EasyAsABC123/Chromance/Models/README.md

# Models

The existing `RegularNode.f3d`, `TopCenterNode.f3d`, `TopLeftNode.f3d` and
`TopRightNode.f3d` files are the Chromance lighting-node designs.

[ESP32 enclosure](ESP32Enclosure/) contains a separate parametric under-desk
controller enclosure, preserved design revisions, STEP solids for Fusion, 3MF
print meshes, geometry previews, hardware notes and a reproducible Python CAD
environment.
