EasyAsABC123/Chromance/Models/ESP32Enclosure/revisions/008-corner-bosses/replacement-parts.png

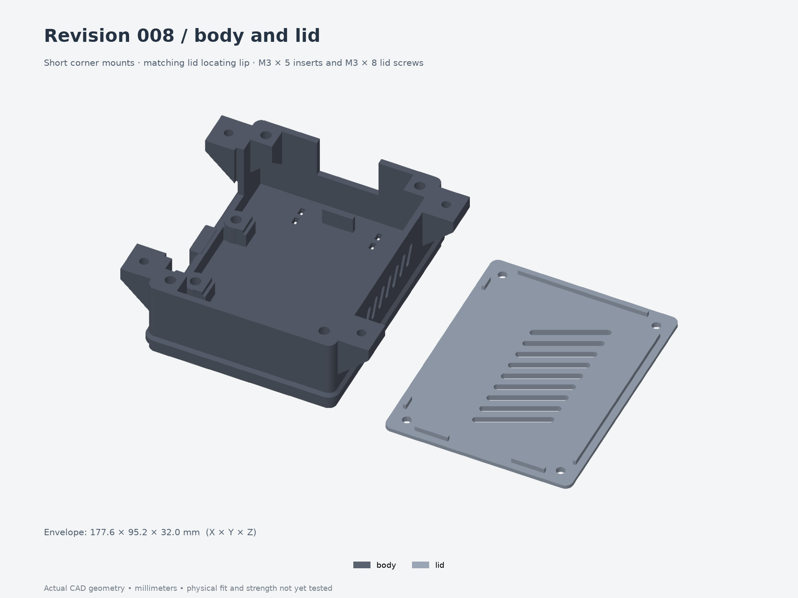
Models/ESP32Enclosure/revisions/008-corner-bosses/replacement-parts.png
