EasyAsABC123/Chromance/Models/ESP32Enclosure/fit-tests/001-board-fit/assembly.step

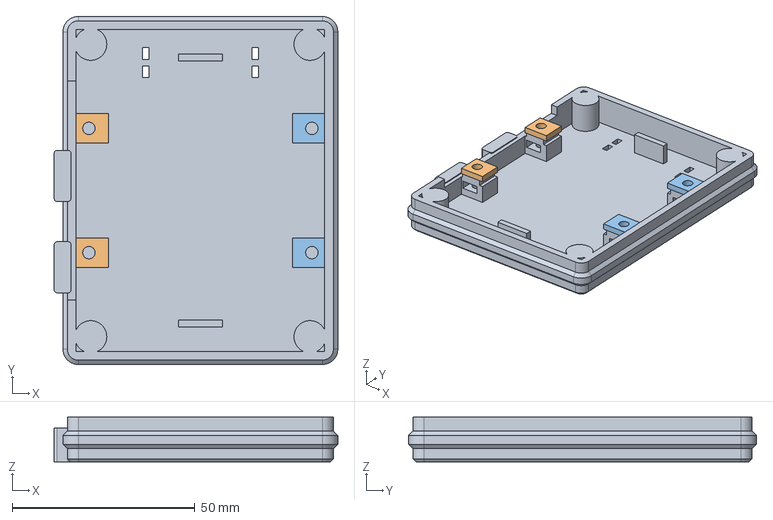
[picture p4: CAD file, 2026-09-10]
Models/ESP32Enclosure/fit-tests/001-board-fit/assembly.step
77.6 x 95.2 x 12.2 mm
