EasyAsABC123/Chromance/Models/ESP32Enclosure/revisions/009-cable-retention/assembly.step

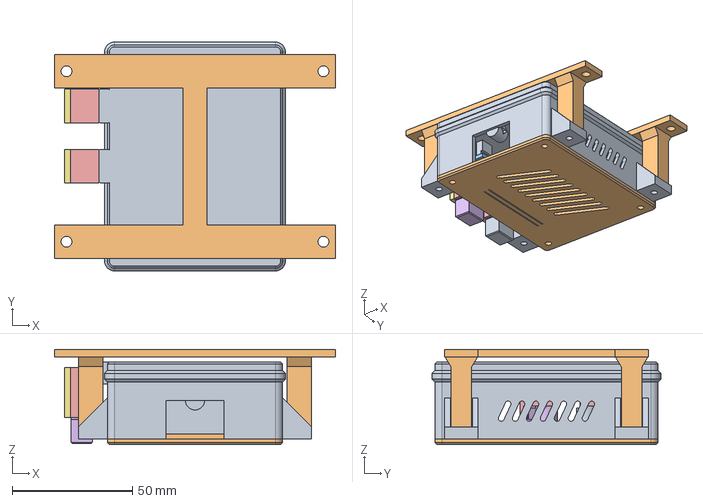
[picture p5: CAD file, 2026-09-11]
Models/ESP32Enclosure/revisions/009-cable-retention/assembly.step
116.8 x 95.2 x 39.6 mm
