EasyAsABC123/Chromance/Models/ESP32Enclosure/revisions/013-measured-buttons/assembly.step

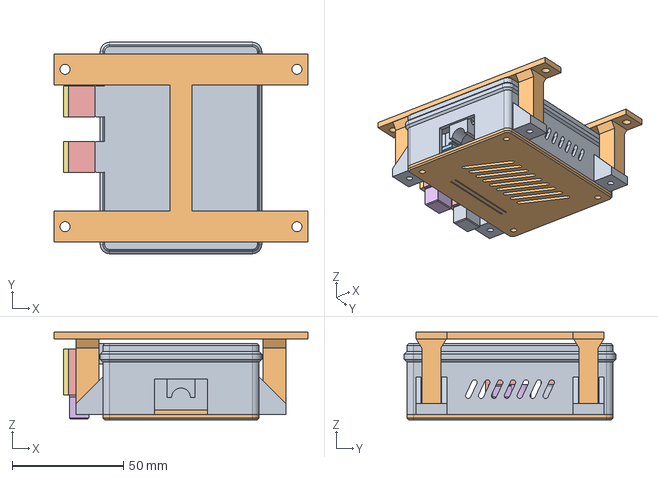
[picture p6: CAD file, 2026-09-13]
Models/ESP32Enclosure/revisions/013-measured-buttons/assembly.step
114.3 x 95.2 x 39.6 mm
