EasyAsABC123/Chromance/Models/ESP32Enclosure/fit-tests/003-cable-retention/assembly.step

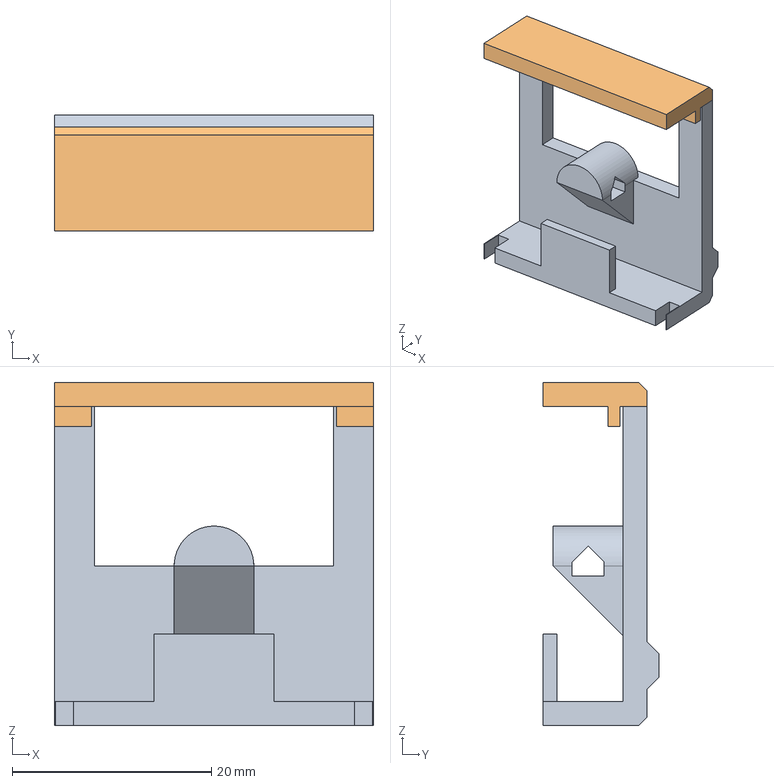
[picture p7: CAD file, 2026-09-11]
Models/ESP32Enclosure/fit-tests/003-cable-retention/assembly.step
32.0 x 11.6 x 34.4 mm
