EasyAsABC123/Chromance/Models/ESP32Enclosure/fit-tests/005-board-width/assembly.step

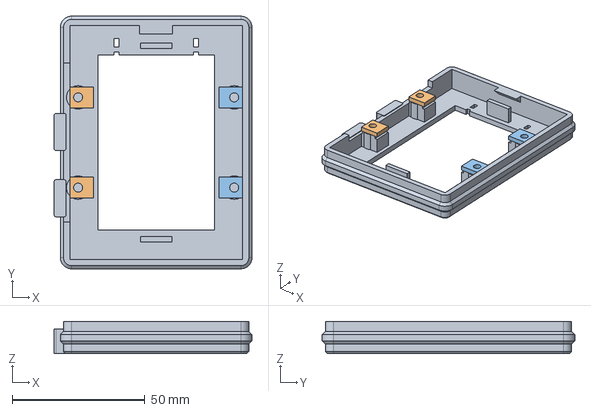
[picture p8: CAD file, 2026-09-11]
Models/ESP32Enclosure/fit-tests/005-board-width/assembly.step
74.6 x 95.2 x 12.2 mm
