EasyAsABC123/Chromance/Models/ESP32Enclosure/fit-tests/008-button-alignment/assembly.step

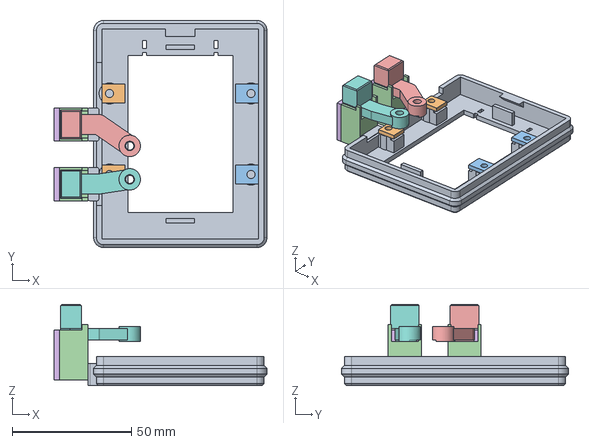
[picture p9: CAD file, 2026-09-13]
Models/ESP32Enclosure/fit-tests/008-button-alignment/assembly.step
89.3 x 95.2 x 34.0 mm
