EasyAsABC123/Chromance/Models/ESP32Enclosure/fit-tests/006-cable-cradle/assembly.step

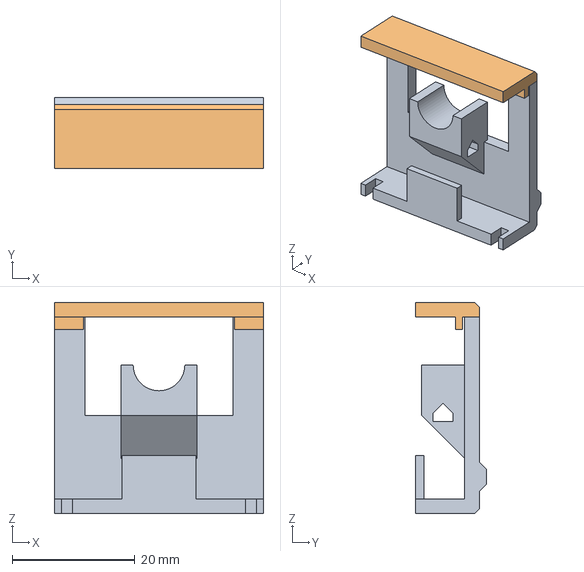
[picture p10: CAD file, 2026-09-11]
Models/ESP32Enclosure/fit-tests/006-cable-cradle/assembly.step
34.0 x 11.6 x 34.4 mm
