EasyAsABC123/Chromance/Models/ESP32Enclosure/revisions/001-generic/assembly.step

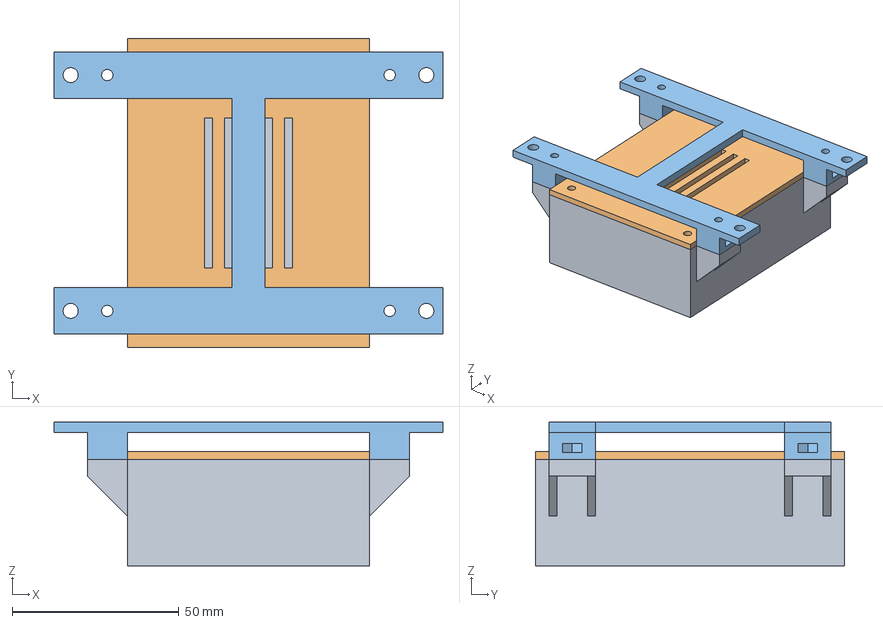
[picture p11: CAD file, 2026-09-09]
Models/ESP32Enclosure/revisions/001-generic/assembly.step
116.8 x 92.8 x 43.2 mm
