EasyAsABC123/Chromance/Models/ESP32Enclosure/revisions/002-console/assembly.step

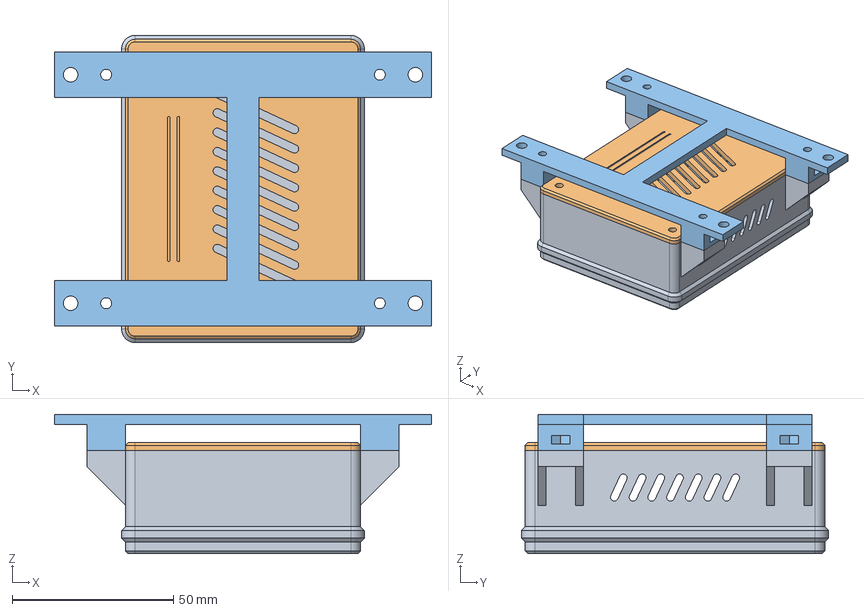
[picture p12: CAD file, 2026-09-09]
Models/ESP32Enclosure/revisions/002-console/assembly.step
116.8 x 95.2 x 43.2 mm
