EasyAsABC123/Chromance/Models/ESP32Enclosure/revisions/003-buttons/assembly.step

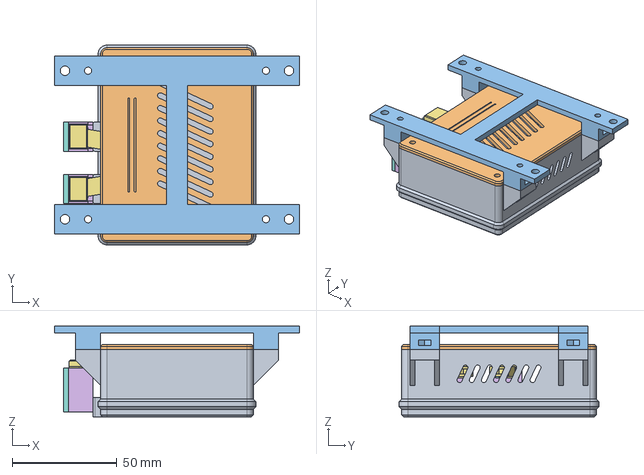
[picture p13: CAD file, 2026-09-09]
Models/ESP32Enclosure/revisions/003-buttons/assembly.step
116.8 x 95.2 x 43.2 mm
