EasyAsABC123/Chromance/Models/ESP32Enclosure/revisions/005-downward-buttons/assembly.step

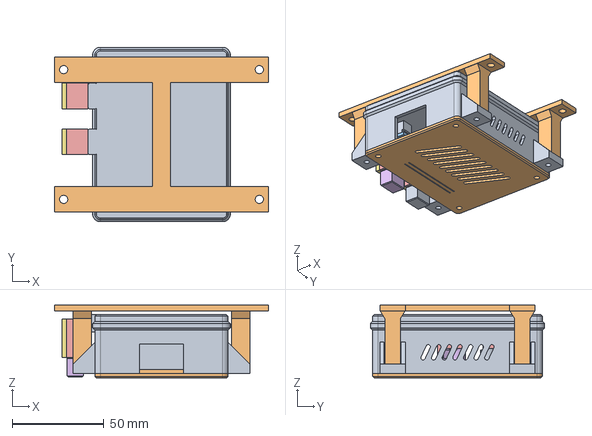
[picture p14: CAD file, 2026-09-10]
Models/ESP32Enclosure/revisions/005-downward-buttons/assembly.step
116.8 x 95.2 x 39.6 mm
