EasyAsABC123/Chromance/Models/ESP32Enclosure/revisions/007-pcb-heatsets/assembly.step

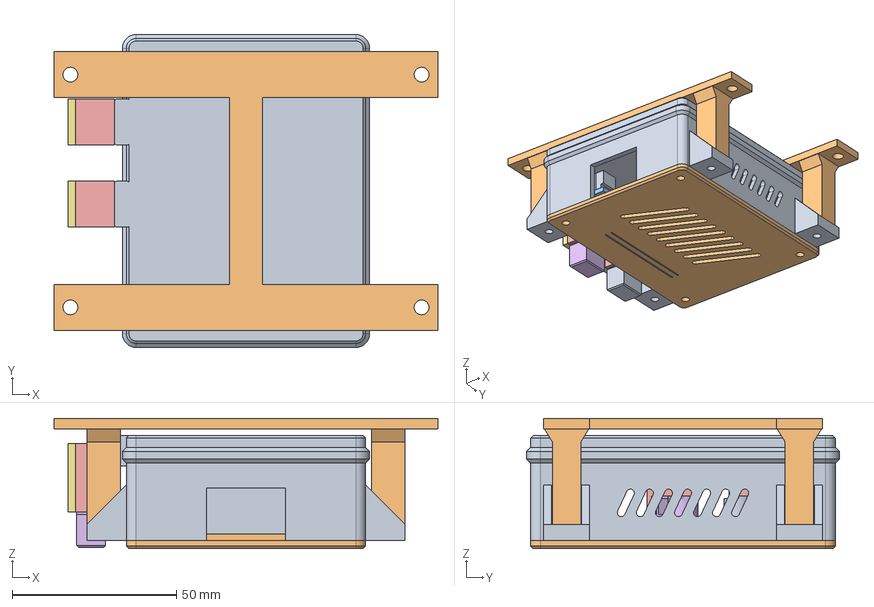
[picture p15: CAD file, 2026-09-11]
Models/ESP32Enclosure/revisions/007-pcb-heatsets/assembly.step
116.8 x 95.2 x 39.6 mm
