EasyAsABC123/Chromance/Models/ESP32Enclosure/fit-tests/002-board-fit-heatsets/parts/board_fit_tray.step

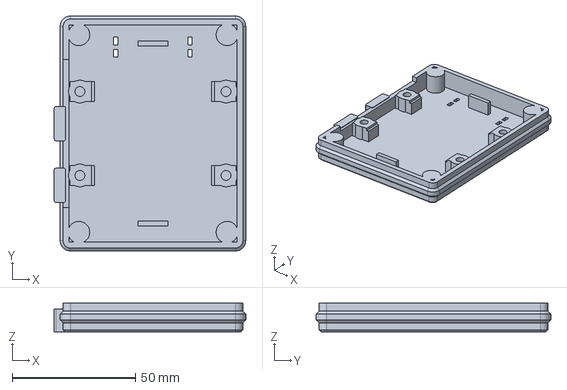
[picture p17: CAD file, 2026-09-10]
Models/ESP32Enclosure/fit-tests/002-board-fit-heatsets/parts/board_fit_tray.step
77.6 x 95.2 x 11.6 mm
