EasyAsABC123/Chromance/Models/ESP32Enclosure/fit-tests/006-cable-cradle/parts/cable_fit_body.step

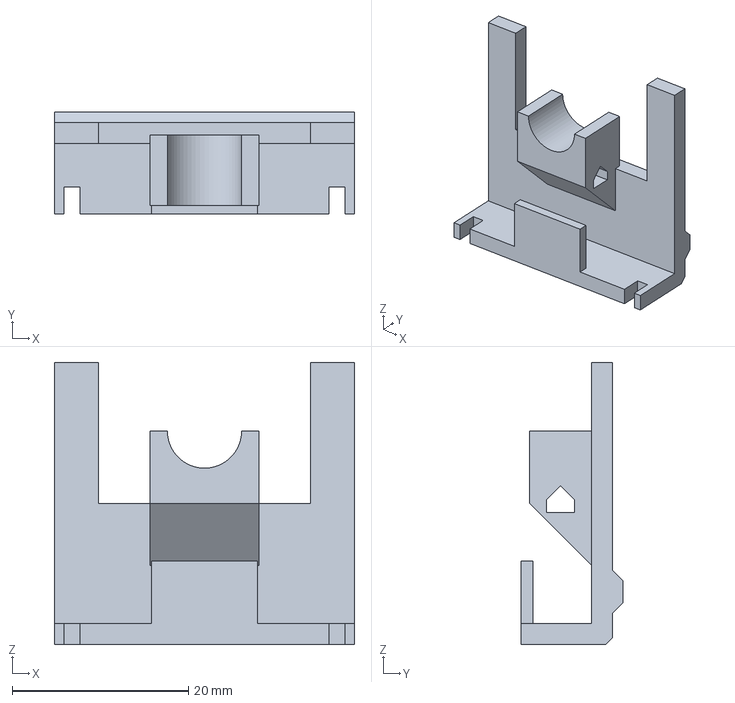
[picture p18: CAD file, 2026-09-11]
Models/ESP32Enclosure/fit-tests/006-cable-cradle/parts/cable_fit_body.step
34.0 x 11.6 x 32.0 mm
