EasyAsABC123/Chromance/Models/ESP32Enclosure/fit-tests/007-board-easier-fit/parts/board_fit_frame.step

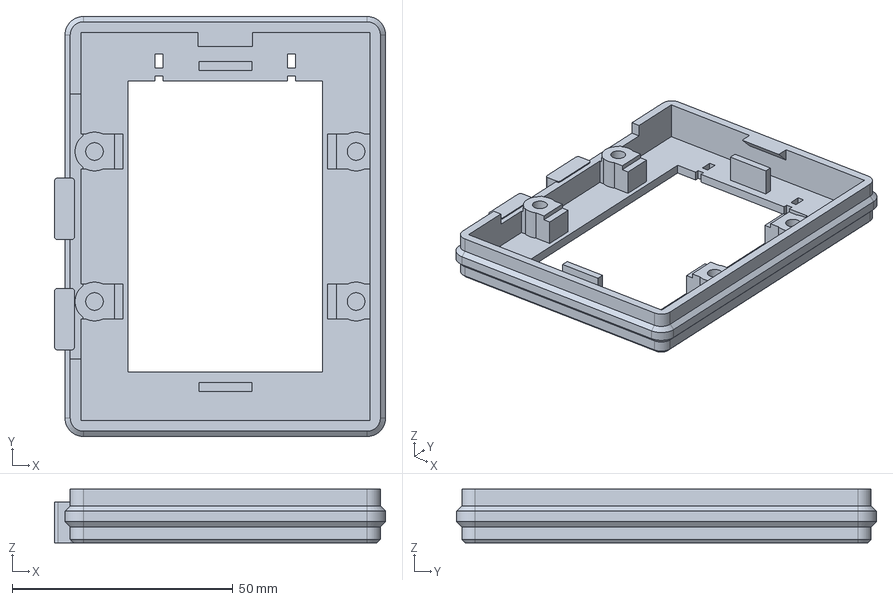
[picture p19: CAD file, 2026-09-11]
Models/ESP32Enclosure/fit-tests/007-board-easier-fit/parts/board_fit_frame.step
75.1 x 95.2 x 12.2 mm
