EasyAsABC123/Chromance/Models/ESP32Enclosure/fit-tests/009-usb-clearance/hardware-reference.step

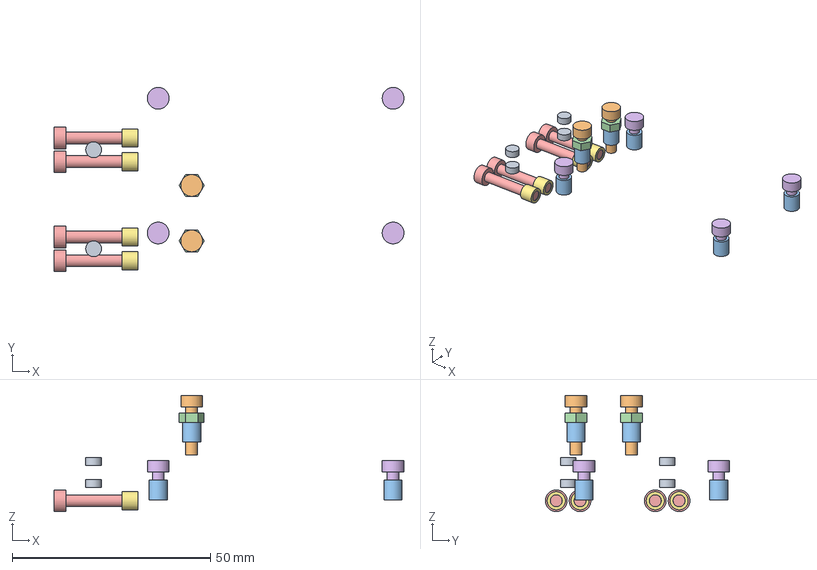
[picture p20: CAD file, 2026-09-13]
Models/ESP32Enclosure/fit-tests/009-usb-clearance/hardware-reference.step
88.3 x 46.5 x 29.4 mm
