EasyAsABC123/Chromance/Models/ESP32Enclosure/fit-tests/009-usb-clearance/parts/reset_moving_magnet_keeper.step

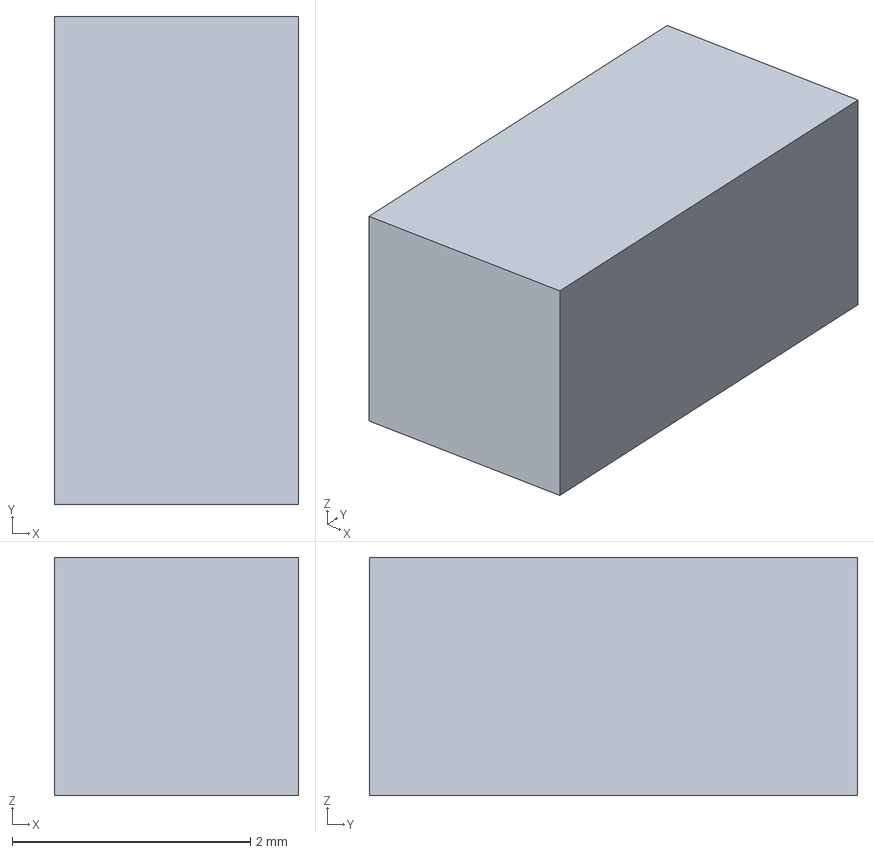
[picture p21: CAD file, 2026-09-13]
Models/ESP32Enclosure/fit-tests/009-usb-clearance/parts/reset_moving_magnet_keeper.step
2.05 x 4.10 x 2.00 mm
