EasyAsABC123/Chromance/Models/ESP32Enclosure/revisions/014-usb-clearance/hardware-reference.step

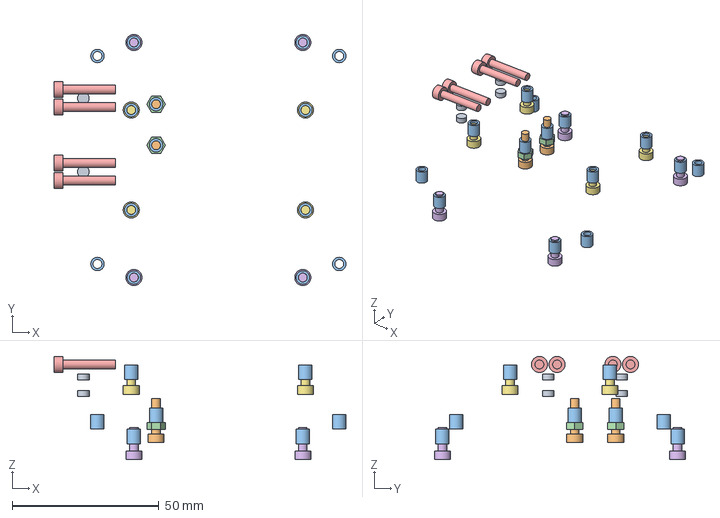
[picture p22: CAD file, 2026-09-13]
Models/ESP32Enclosure/revisions/014-usb-clearance/hardware-reference.step
99.4 x 85.5 x 35.2 mm
