EasyAsABC123/Chromance/Models/ESP32Enclosure/fit-tests/006-cable-cradle/parts/cable_fit_lid.step

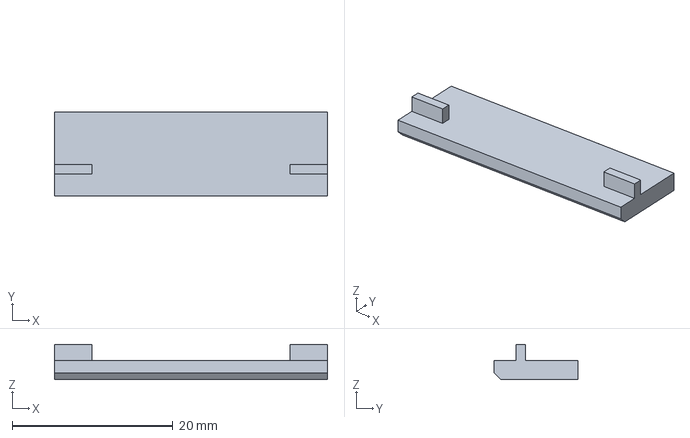
[picture p23: CAD file, 2026-09-11]
Models/ESP32Enclosure/fit-tests/006-cable-cradle/parts/cable_fit_lid.step
34.0 x 10.4 x 4.40 mm
