EasyAsABC123/Chromance/Models/ESP32Enclosure/fit-tests/009-usb-clearance/parts/boot_rear_keeper.step

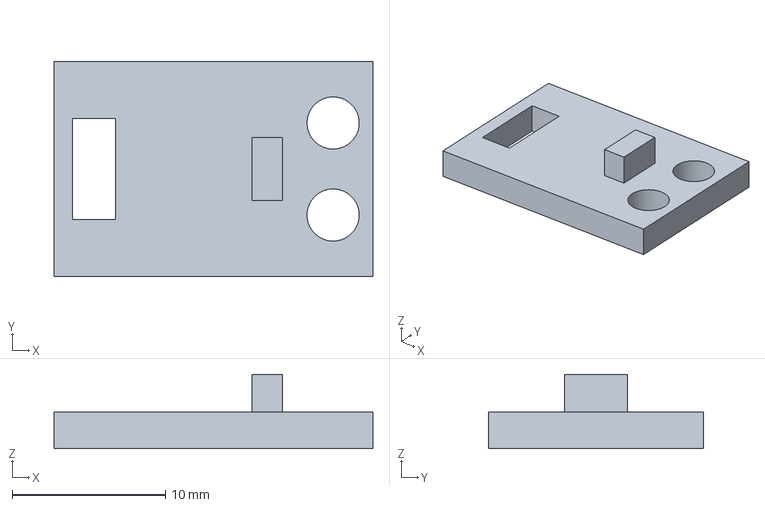
[picture p24: CAD file, 2026-09-13]
Models/ESP32Enclosure/fit-tests/009-usb-clearance/parts/boot_rear_keeper.step
20.8 x 14.0 x 4.85 mm
