EasyAsABC123/Chromance/Models/ESP32Enclosure/fit-tests/009-usb-clearance/replacements-only.3mf

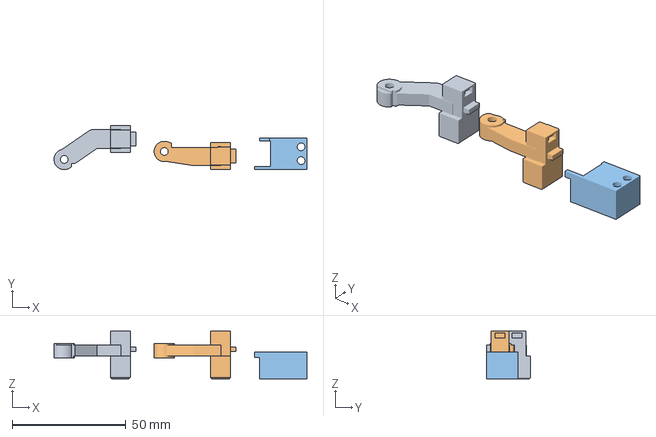
[picture p25: CAD file, 2026-09-13]
Models/ESP32Enclosure/fit-tests/009-usb-clearance/replacements-only.3mf
111.3 x 19.5 x 21.0 mm
