EasyAsABC123/Chromance/Models/ESP32Enclosure/revisions/008-corner-bosses/hardware-reference.step

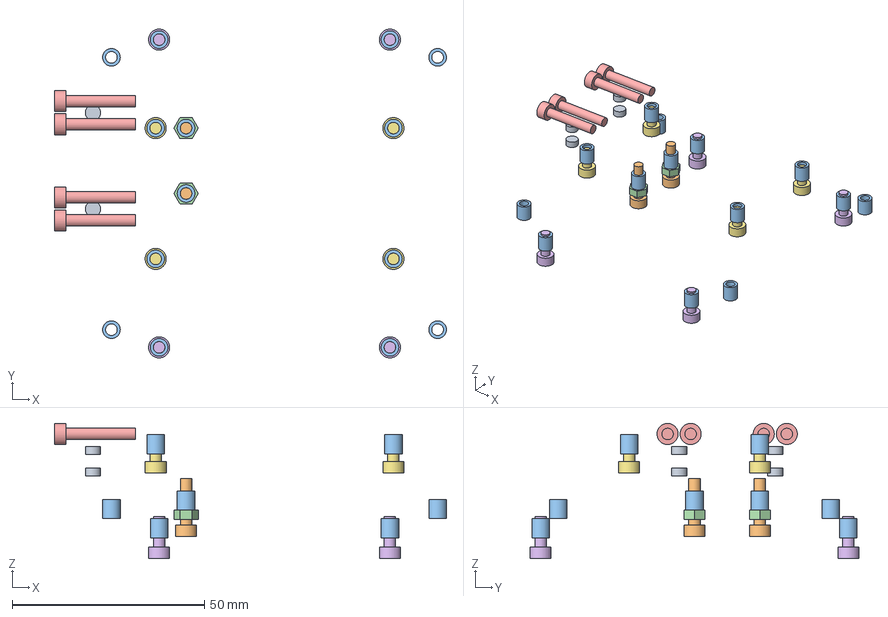
[picture p26: CAD file, 2026-09-11]
Models/ESP32Enclosure/revisions/008-corner-bosses/hardware-reference.step
101.9 x 85.5 x 35.2 mm
