EasyAsABC123/Chromance/Models/ESP32Enclosure/revisions/014-usb-clearance/parts/boot_frame.step

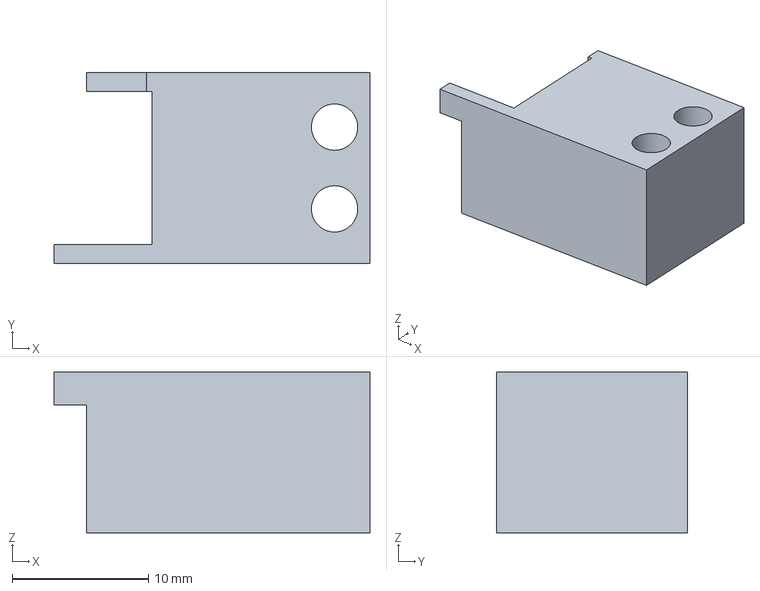
[picture p27: CAD file, 2026-09-13]
Models/ESP32Enclosure/revisions/014-usb-clearance/parts/boot_frame.step
23.2 x 14.0 x 11.8 mm
