EasyAsABC123/Chromance/Models/ESP32Enclosure/revisions/014-usb-clearance/print-layout.3mf

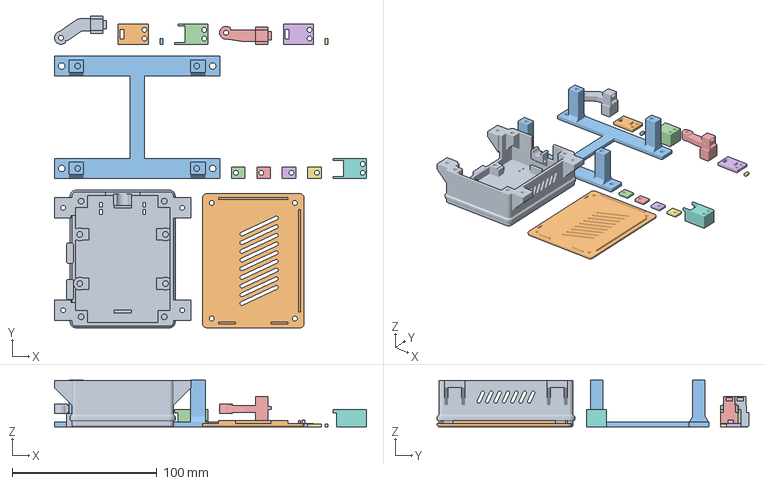
[picture p28: CAD file, 2026-09-13]
Models/ESP32Enclosure/revisions/014-usb-clearance/print-layout.3mf
215.7 x 215.5 x 32.2 mm
