EasyAsABC123/Chromance/Models/ESP32Enclosure/fit-tests/009-usb-clearance/parts/pcb_clamp_right_rear.step

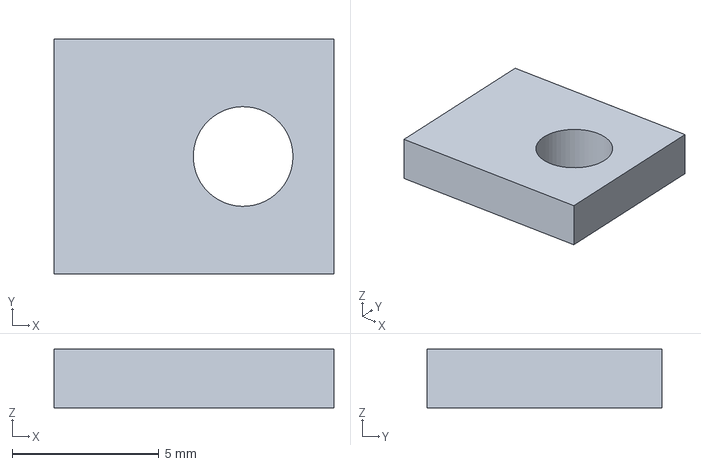
[picture p29: CAD file, 2026-09-13]
Models/ESP32Enclosure/fit-tests/009-usb-clearance/parts/pcb_clamp_right_rear.step
9.55 x 8.00 x 2.00 mm
