EasyAsABC123/Chromance/Models/ESP32Enclosure/revisions/008-corner-bosses/replacement-parts.3mf

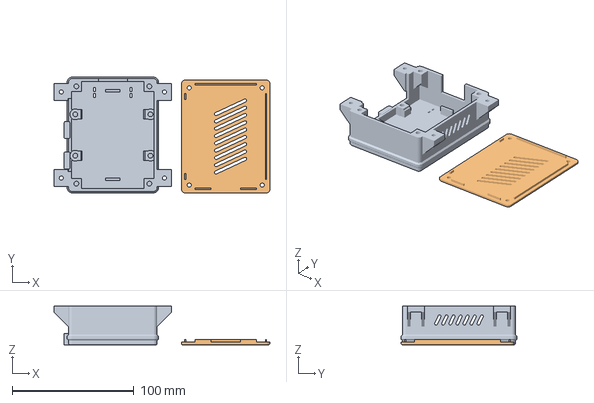
[picture p30: CAD file, 2026-09-11]
Models/ESP32Enclosure/revisions/008-corner-bosses/replacement-parts.3mf
177.6 x 95.2 x 32.0 mm
