EasyAsABC123/Chromance/Models/ESP32Enclosure/revisions/014-usb-clearance/parts/body.step

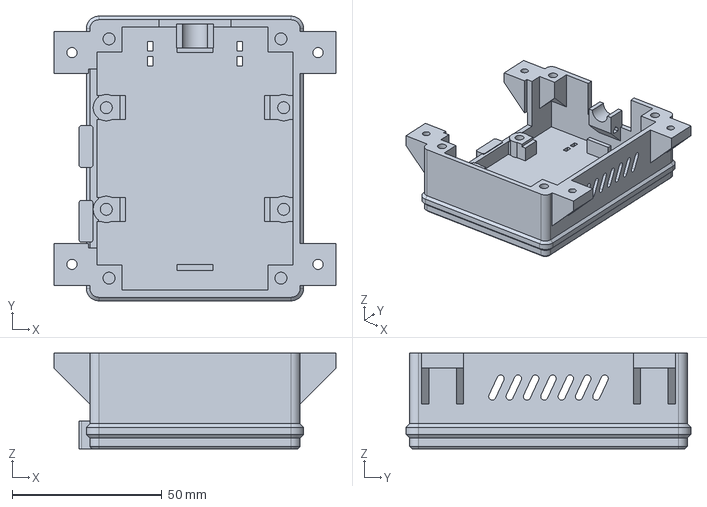
[picture p31: CAD file, 2026-09-13]
Models/ESP32Enclosure/revisions/014-usb-clearance/parts/body.step
94.3 x 95.2 x 32.0 mm
