EasyAsABC123/Chromance/Models/ESP32Enclosure/fit-tests/008-button-alignment/sliders-only.3mf

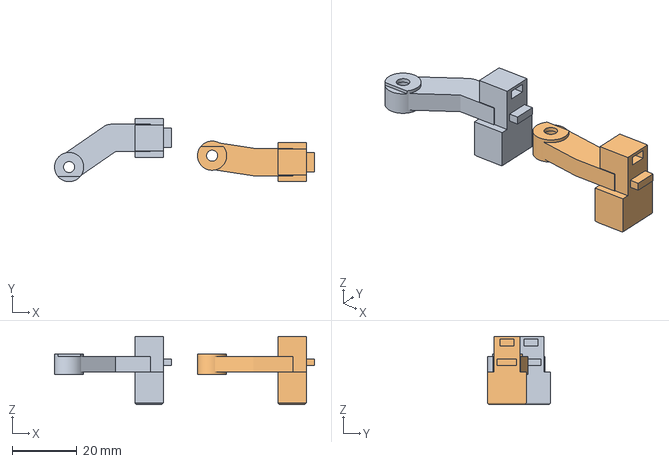
[picture p32: CAD file, 2026-09-13]
Models/ESP32Enclosure/fit-tests/008-button-alignment/sliders-only.3mf
80.1 x 19.5 x 21.0 mm
