EasyAsABC123/Chromance/Models/ESP32Enclosure/revisions/011-fit-and-cable-cradle/print-layout.3mf

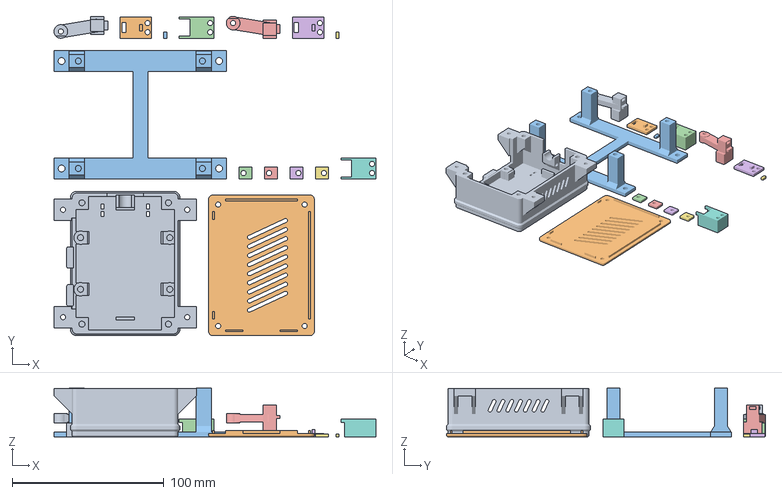
[picture p33: CAD file, 2026-09-11]
Models/ESP32Enclosure/revisions/011-fit-and-cable-cradle/print-layout.3mf
212.2 x 210.5 x 32.2 mm
