EasyAsABC123/Chromance/Models/ESP32Enclosure/fit-tests/009-usb-clearance/parts/reset_frame.step

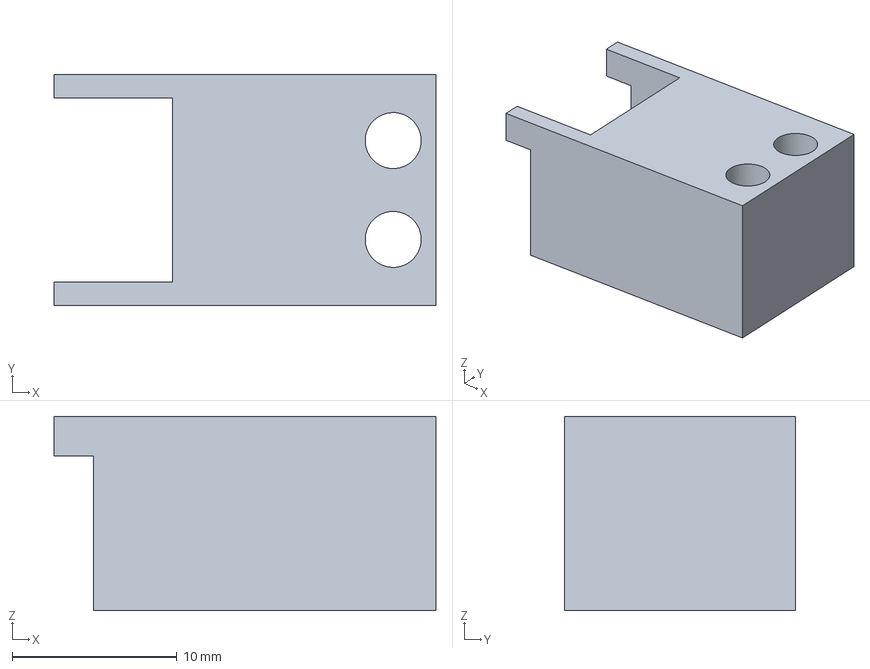
[picture p34: CAD file, 2026-09-13]
Models/ESP32Enclosure/fit-tests/009-usb-clearance/parts/reset_frame.step
23.2 x 14.0 x 11.8 mm
