EasyAsABC123/Chromance/Models/ESP32Enclosure/fit-tests/009-usb-clearance/print-layout.3mf

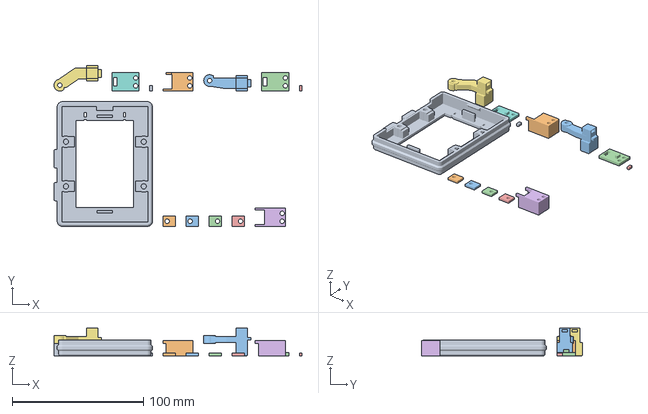
[picture p35: CAD file, 2026-09-13]
Models/ESP32Enclosure/fit-tests/009-usb-clearance/print-layout.3mf
189.0 x 122.7 x 21.0 mm
