EasyAsABC123/Chromance/Models/ESP32Enclosure/revisions/008-corner-bosses/print-layout.3mf

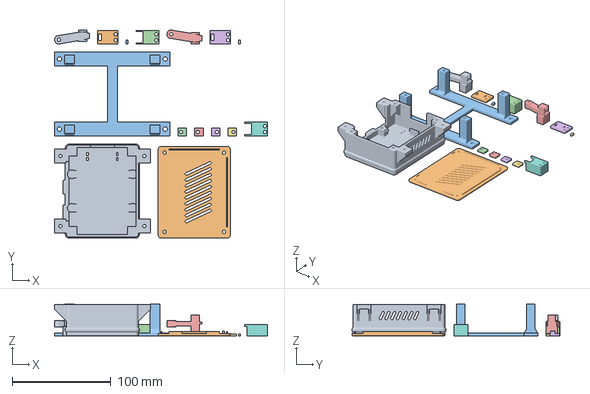
[picture p36: CAD file, 2026-09-11]
Models/ESP32Enclosure/revisions/008-corner-bosses/print-layout.3mf
215.2 x 210.5 x 32.2 mm
