EasyAsABC123/Chromance/Models/ESP32Enclosure/revisions/014-usb-clearance/parts/lid.step

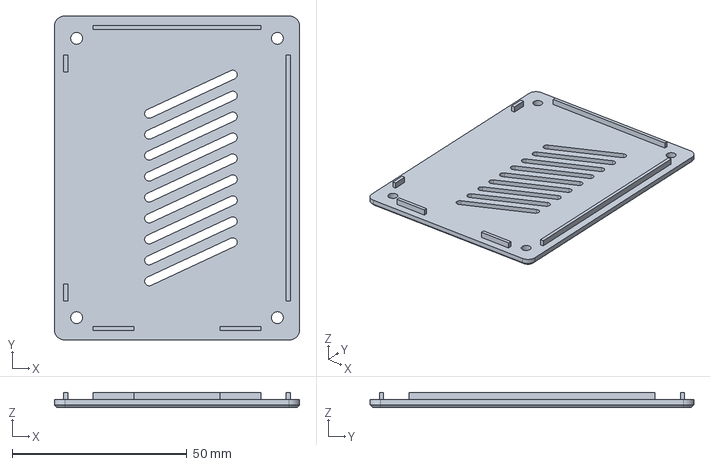
[picture p37: CAD file, 2026-09-13]
Models/ESP32Enclosure/revisions/014-usb-clearance/parts/lid.step
70.3 x 92.8 x 4.40 mm
