EasyAsABC123/Chromance/Models/ESP32Enclosure/fit-tests/009-usb-clearance/parts/reset_slider.step

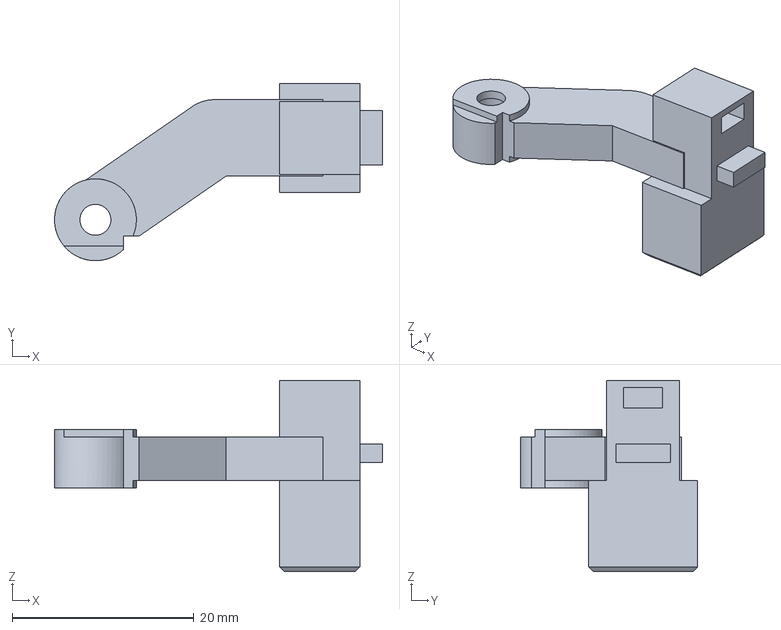
[picture p38: CAD file, 2026-09-13]
Models/ESP32Enclosure/fit-tests/009-usb-clearance/parts/reset_slider.step
36.0 x 19.5 x 21.0 mm
