EasyAsABC123/Chromance/Models/ESP32Enclosure/fit-tests/009-usb-clearance/parts/boot_slider.step

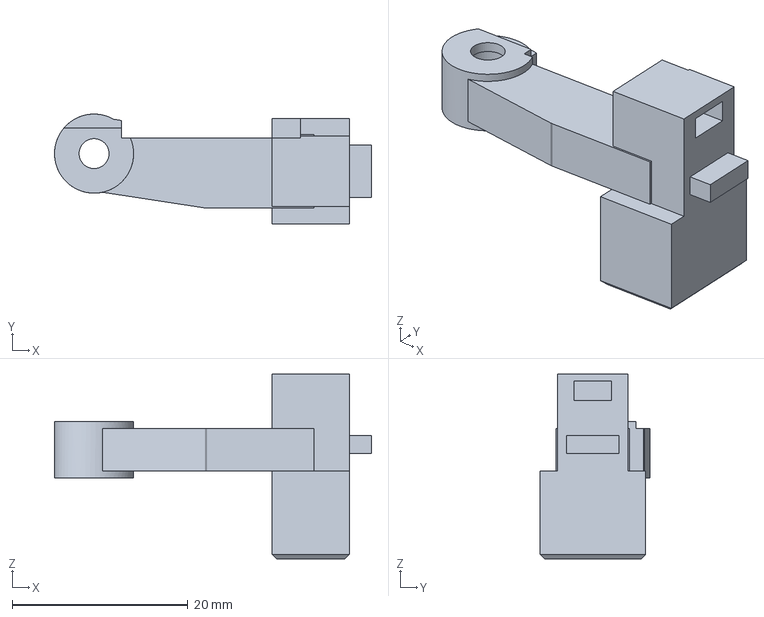
[picture p39: CAD file, 2026-09-13]
Models/ESP32Enclosure/fit-tests/009-usb-clearance/parts/boot_slider.step
36.0 x 12.5 x 21.0 mm
