EasyAsABC123/Chromance/Models/ESP32Enclosure/revisions/014-usb-clearance/parts/desk_bracket.step

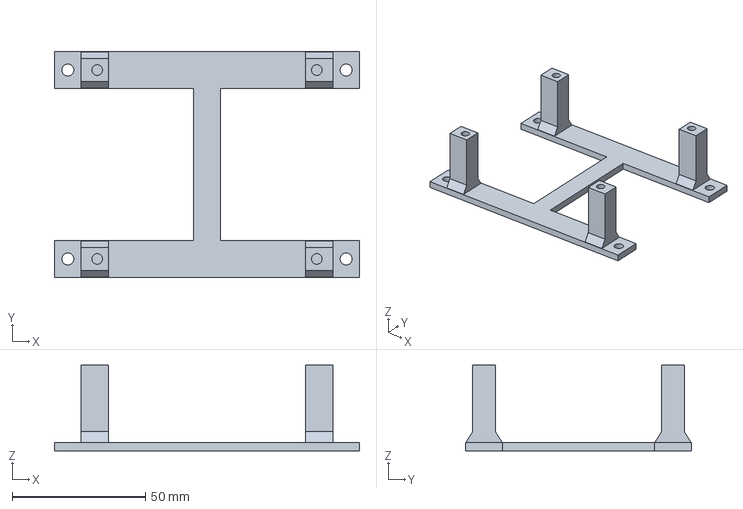
[picture p40: CAD file, 2026-09-13]
Models/ESP32Enclosure/revisions/014-usb-clearance/parts/desk_bracket.step
114.3 x 84.8 x 32.2 mm
