EasyAsABC123/Chromance/(list of files, cad)

Other CAD files:
Models/ESP32Enclosure/revisions/011-fit-and-cable-cradle/assembly.step
Models/ESP32Enclosure/fit-tests/004-8mm-cable/assembly.step
Models/ESP32Enclosure/fit-tests/007-board-easier-fit/assembly.step
Models/ESP32Enclosure/revisions/010-8mm-cable/assembly.step
Models/ESP32Enclosure/revisions/012-easier-board-fit/assembly.step
Models/ESP32Enclosure/fit-tests/002-board-fit-heatsets/assembly.step
Models/ESP32Enclosure/revisions/004-heatsets/assembly.step
Models/ESP32Enclosure/revisions/006-lid-heatsets/assembly.step
Models/ESP32Enclosure/revisions/008-corner-bosses/assembly.step
Models/ESP32Enclosure/revisions/014-usb-clearance/assembly.step
Models/ESP32Enclosure/revisions/008-corner-bosses/inspection.FCStd
Models/ESP32Enclosure/revisions/011-fit-and-cable-cradle/inspection.FCStd
Models/ESP32Enclosure/revisions/014-usb-clearance/parts/boot_moving_magnet_keeper.step
Models/ESP32Enclosure/fit-tests/009-usb-clearance/inspection.FCStd
Models/ESP32Enclosure/revisions/011-fit-and-cable-cradle/hardware-reference.step
Models/ESP32Enclosure/revisions/014-usb-clearance/inspection.FCStd
Models/ESP32Enclosure/fit-tests/009-usb-clearance/parts/pcb_clamp_left_rear.step
Models/ESP32Enclosure/revisions/014-usb-clearance/parts/pcb_clamp_left_rear.step
Models/ESP32Enclosure/revisions/014-usb-clearance/parts/pcb_clamp_left_front.step
Models/ESP32Enclosure/revisions/014-usb-clearance/parts/boot_slider.step
Models/ESP32Enclosure/fit-tests/009-usb-clearance/parts/button_fit_frame.step
Models/ESP32Enclosure/revisions/014-usb-clearance/parts/reset_moving_magnet_keeper.step
Models/ESP32Enclosure/fit-tests/009-usb-clearance/parts/boot_moving_magnet_keeper.step
Models/ESP32Enclosure/revisions/014-usb-clearance/parts/pcb_clamp_right_rear.step
Models/ESP32Enclosure/fit-tests/009-usb-clearance/parts/pcb_clamp_left_front.step
Models/ESP32Enclosure/revisions/014-usb-clearance/parts/reset_frame.step
Models/ESP32Enclosure/fit-tests/009-usb-clearance/parts/pcb_clamp_right_front.step
Models/ESP32Enclosure/fit-tests/009-usb-clearance/parts/reset_rear_keeper.step
Models/ESP32Enclosure/revisions/014-usb-clearance/parts/reset_rear_keeper.step
Models/ESP32Enclosure/fit-tests/009-usb-clearance/parts/boot_frame.step
Models/ESP32Enclosure/revisions/014-usb-clearance/parts/pcb_clamp_right_front.step
Models/ESP32Enclosure/revisions/014-usb-clearance/parts/boot_rear_keeper.step
Models/ESP32Enclosure/revisions/014-usb-clearance/parts/reset_slider.step
Models/ESP32Enclosure/fit-tests/001-board-fit/inspection.FCStd
Models/ESP32Enclosure/fit-tests/001-board-fit/parts/board_fit_tray.3mf
Models/ESP32Enclosure/fit-tests/001-board-fit/parts/board_fit_tray.step
Models/ESP32Enclosure/fit-tests/001-board-fit/parts/pcb_clamp_left_front.3mf
Models/ESP32Enclosure/fit-tests/001-board-fit/parts/pcb_clamp_left_front.step
Models/ESP32Enclosure/fit-tests/001-board-fit/parts/pcb_clamp_left_rear.3mf
Models/ESP32Enclosure/fit-tests/001-board-fit/parts/pcb_clamp_left_rear.step
Models/ESP32Enclosure/fit-tests/001-board-fit/parts/pcb_clamp_right_front.3mf
Models/ESP32Enclosure/fit-tests/001-board-fit/parts/pcb_clamp_right_front.step
Models/ESP32Enclosure/fit-tests/001-board-fit/parts/pcb_clamp_right_rear.3mf
Models/ESP32Enclosure/fit-tests/001-board-fit/parts/pcb_clamp_right_rear.step
Models/ESP32Enclosure/fit-tests/001-board-fit/print-layout.3mf
Models/ESP32Enclosure/fit-tests/002-board-fit-heatsets/hardware-reference.step
Models/ESP32Enclosure/fit-tests/002-board-fit-heatsets/inspection.FCStd
Models/ESP32Enclosure/fit-tests/002-board-fit-heatsets/parts/board_fit_tray.3mf
Models/ESP32Enclosure/fit-tests/002-board-fit-heatsets/parts/pcb_clamp_left_front.3mf
Models/ESP32Enclosure/fit-tests/002-board-fit-heatsets/parts/pcb_clamp_left_front.step
Models/ESP32Enclosure/fit-tests/002-board-fit-heatsets/parts/pcb_clamp_left_rear.3mf
Models/ESP32Enclosure/fit-tests/002-board-fit-heatsets/parts/pcb_clamp_left_rear.step
Models/ESP32Enclosure/fit-tests/002-board-fit-heatsets/parts/pcb_clamp_right_front.3mf
Models/ESP32Enclosure/fit-tests/002-board-fit-heatsets/parts/pcb_clamp_right_front.step
Models/ESP32Enclosure/fit-tests/002-board-fit-heatsets/parts/pcb_clamp_right_rear.3mf
Models/ESP32Enclosure/fit-tests/002-board-fit-heatsets/parts/pcb_clamp_right_rear.step
Models/ESP32Enclosure/fit-tests/002-board-fit-heatsets/print-layout.3mf
Models/ESP32Enclosure/fit-tests/003-cable-retention/inspection.FCStd
Models/ESP32Enclosure/fit-tests/003-cable-retention/parts/cable_fit_body.3mf
Models/ESP32Enclosure/fit-tests/003-cable-retention/parts/cable_fit_body.step
Models/ESP32Enclosure/fit-tests/003-cable-retention/parts/cable_fit_lid.3mf
Models/ESP32Enclosure/fit-tests/003-cable-retention/parts/cable_fit_lid.step
Models/ESP32Enclosure/fit-tests/003-cable-retention/print-layout.3mf
Models/ESP32Enclosure/fit-tests/004-8mm-cable/inspection.FCStd
Models/ESP32Enclosure/fit-tests/004-8mm-cable/parts/cable_fit_body.3mf
Models/ESP32Enclosure/fit-tests/004-8mm-cable/parts/cable_fit_body.step
Models/ESP32Enclosure/fit-tests/004-8mm-cable/parts/cable_fit_lid.3mf
Models/ESP32Enclosure/fit-tests/004-8mm-cable/parts/cable_fit_lid.step
Models/ESP32Enclosure/fit-tests/004-8mm-cable/print-layout.3mf
Models/ESP32Enclosure/fit-tests/005-board-width/inspection.FCStd
Models/ESP32Enclosure/fit-tests/005-board-width/parts/board_fit_frame.3mf
Models/ESP32Enclosure/fit-tests/005-board-width/parts/board_fit_frame.step
Models/ESP32Enclosure/fit-tests/005-board-width/parts/pcb_clamp_left_front.3mf
Models/ESP32Enclosure/fit-tests/005-board-width/parts/pcb_clamp_left_front.step
Models/ESP32Enclosure/fit-tests/005-board-width/parts/pcb_clamp_left_rear.3mf
Models/ESP32Enclosure/fit-tests/005-board-width/parts/pcb_clamp_left_rear.step
Models/ESP32Enclosure/fit-tests/005-board-width/parts/pcb_clamp_right_front.3mf
Models/ESP32Enclosure/fit-tests/005-board-width/parts/pcb_clamp_right_front.step
Models/ESP32Enclosure/fit-tests/005-board-width/parts/pcb_clamp_right_rear.3mf
Models/ESP32Enclosure/fit-tests/005-board-width/parts/pcb_clamp_right_rear.step
Models/ESP32Enclosure/fit-tests/005-board-width/print-layout.3mf
Models/ESP32Enclosure/fit-tests/006-cable-cradle/inspection.FCStd
Models/ESP32Enclosure/fit-tests/006-cable-cradle/parts/cable_fit_body.3mf
Models/ESP32Enclosure/fit-tests/006-cable-cradle/parts/cable_fit_lid.3mf
Models/ESP32Enclosure/fit-tests/006-cable-cradle/print-layout.3mf
Models/ESP32Enclosure/fit-tests/007-board-easier-fit/inspection.FCStd
Models/ESP32Enclosure/fit-tests/007-board-easier-fit/parts/board_fit_frame.3mf
Models/ESP32Enclosure/fit-tests/007-board-easier-fit/parts/pcb_clamp_left_front.3mf
Models/ESP32Enclosure/fit-tests/007-board-easier-fit/parts/pcb_clamp_left_front.step
Models/ESP32Enclosure/fit-tests/007-board-easier-fit/parts/pcb_clamp_left_rear.3mf
Models/ESP32Enclosure/fit-tests/007-board-easier-fit/parts/pcb_clamp_left_rear.step
Models/ESP32Enclosure/fit-tests/007-board-easier-fit/parts/pcb_clamp_right_front.3mf
Models/ESP32Enclosure/fit-tests/007-board-easier-fit/parts/pcb_clamp_right_front.step
Models/ESP32Enclosure/fit-tests/007-board-easier-fit/parts/pcb_clamp_right_rear.3mf
Models/ESP32Enclosure/fit-tests/007-board-easier-fit/parts/pcb_clamp_right_rear.step
Models/ESP32Enclosure/fit-tests/007-board-easier-fit/print-layout.3mf
Models/ESP32Enclosure/fit-tests/008-button-alignment/hardware-reference.step
Models/ESP32Enclosure/fit-tests/008-button-alignment/inspection.FCStd
Models/ESP32Enclosure/fit-tests/008-button-alignment/parts/boot_frame.3mf
Models/ESP32Enclosure/fit-tests/008-button-alignment/parts/boot_frame.step
Models/ESP32Enclosure/fit-tests/008-button-alignment/parts/boot_moving_magnet_keeper.3mf
Models/ESP32Enclosure/fit-tests/008-button-alignment/parts/boot_moving_magnet_keeper.step
Models/ESP32Enclosure/fit-tests/008-button-alignment/parts/boot_rear_keeper.3mf
Models/ESP32Enclosure/fit-tests/008-button-alignment/parts/boot_rear_keeper.step
Models/ESP32Enclosure/fit-tests/008-button-alignment/parts/boot_slider.3mf
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
