EasyAsABC123/Chromance/Models/ESP32Enclosure/assembly-guides/013-buttons/README.md

# Revision 013 button assembly

Assembly of the external magnetic-return **EN/RESET and BOOT paddles** for
[revision 013](../../revisions/013-measured-buttons/README.md). Each paddle moves
a nylon screw onto its ESP32 switch; two repelling magnets return the paddle
when released.

**Use the revision 013 sliders.** Their tips match your supplied measurements:
RESET **30 mm** and BOOT **16 mm** from the bottom of the perfboard, both
**3.3 mm from the left edge**. The new arms bend after leaving their guides;
the other thirteen printed pieces are unchanged from revision 012.

Start with the [two-slider quick print](../../fit-tests/008-button-alignment/sliders-only.3mf)
and [fit instructions](../../fit-tests/008-button-alignment/README.md).
The positions assume a centered PCB. The board can move within its retaining
gap, and switch height/travel and plug size remain unmeasured. Confirm physical
alignment before adjusting the contacts; screw height cannot correct a sideways
offset.

**USB fit still needs checking:** the provisional 8 × 6 mm plug box intersects
the left-front PCB clamp screw head. Installing the plug before the cartridges
avoids the obstructed outer approach, but does not fix that screw conflict.
Check your actual connector with the jig before completing assembly.

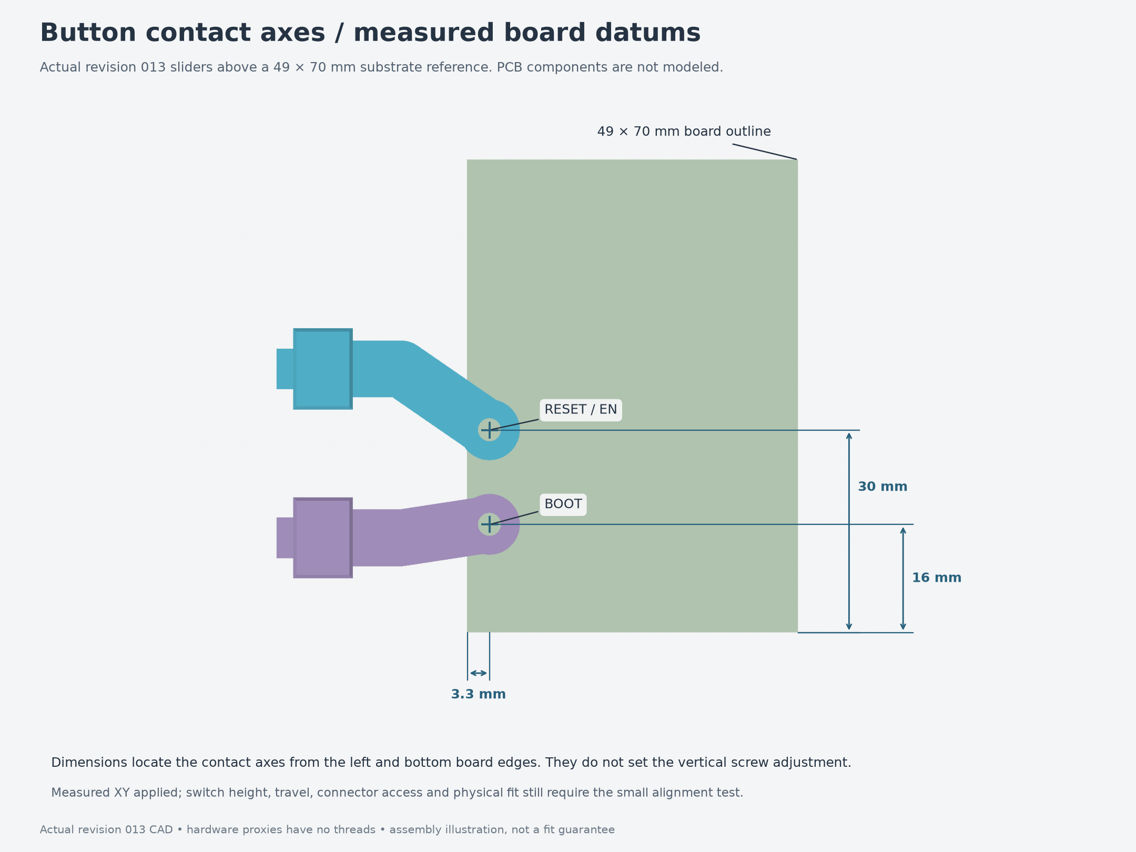
[picture p46: Models/ESP32Enclosure/assembly-guides/013-buttons/04-button-alignment.png]
Measured button positions on the centered perfboard


## Orientation

For assembly, put the **body floor on the bench, lid removed, open side up**.
“Up” and “down” below refer to that position. The slider's arm points inward
toward the board; the rear keeper and mounting screw heads face outward.

On the bench, press the finger pad **down toward the body floor**. Mounted under
the desk, the enclosure is inverted: the lid and exposed pads face down, and
you press the pads **up toward the desk**.

## Parts and hardware

Use the [revision 013 printable parts](../../revisions/013-measured-buttons/parts/).
The RESET and BOOT sliders have different arms: keep each with its named set.
The revision 013 sliders include the revised bends and measured contact axes.
The frame and two keeper shapes for each button can be reused from 012.

| Item | Per button | Both buttons | Where it goes |
| --- | ---: | ---: | --- |
| Printed frame | 1 | 2 | Stationary U-shaped slider guide |
| Printed slider | 1 | 2 | Finger pad, arm and round contact boss |
| Printed rear keeper | 1 | 2 | Large outside plate with a tongue and lug window |
| Printed moving-magnet keeper | 1 | 2 | Tiny rectangular plug in the slider |
| Axially magnetized Ø4 × 2 mm disc magnet | 2 | 4 | One fixed in the frame, one in the slider |
| M3 × 18 socket-head screw | 2 | 4 | Through rear keeper and frame into body pads; head diameter ≤5.5 mm |
| **M3 × 4 mm heat-set insert** | 2 | 4 | Short inserts in the exterior body mounting pads |
| **M3 × 5 mm heat-set insert** | 1 | 2 | Round contact boss at the end of the slider arm |
| Nylon M3 × 12 screw | 1 | 2 | Adjustable contact tip |
| Nylon M3 jam nut | 1 | 2 | Locks the contact adjustment above the boss |

These quantities cover the buttons only. The nylon jam nut is an exposed
adjustment lock; there is **no captive nut pocket** in this contact joint.

**Do not swap the two insert lengths.** The body cartridge-mount pilots are
only 4.4 mm deep and take the short 4 mm inserts. The contact boss takes the
5 mm insert. Both currently assume a 4.6 mm insert outside diameter and a
4.0 mm pilot: check your actual inserts, since “M3 × 5” does not specify the
outside diameter.

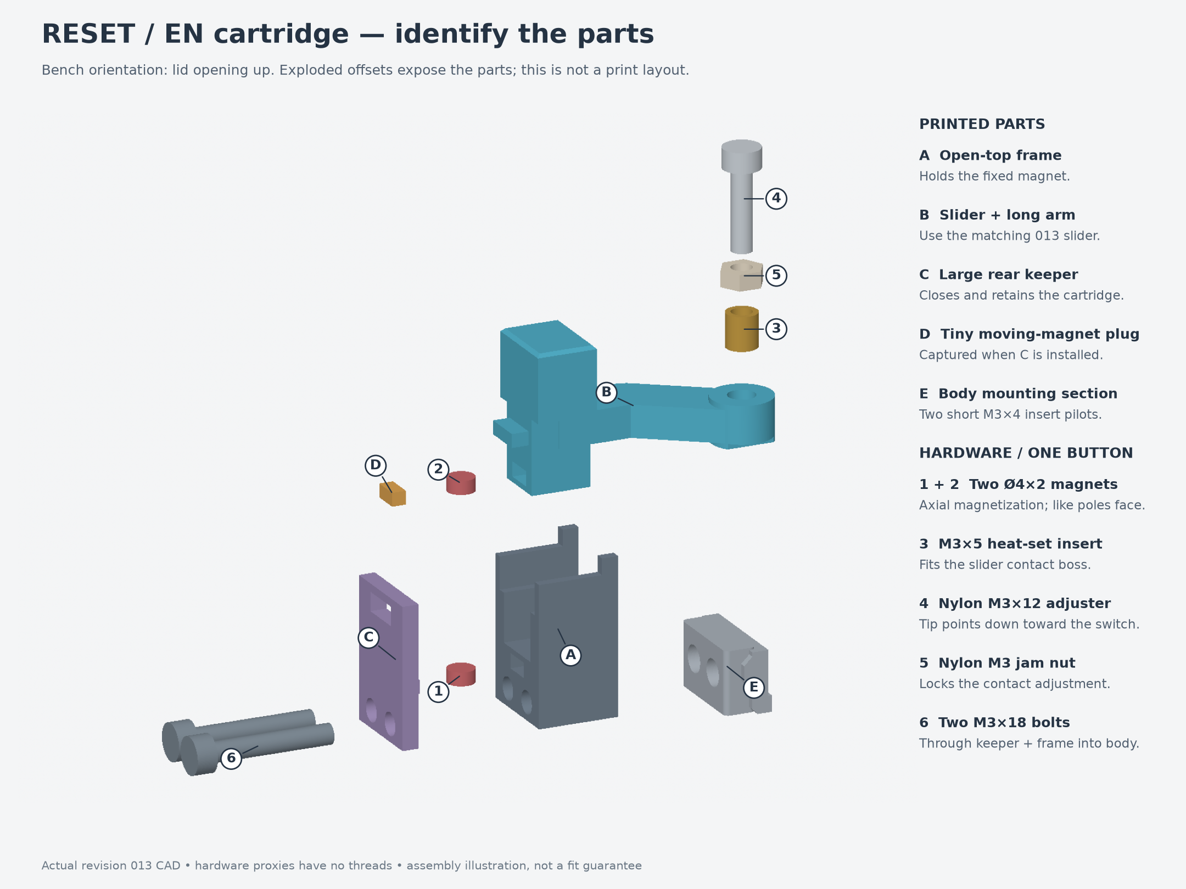
[picture p47: Models/ESP32Enclosure/assembly-guides/013-buttons/01-reset-exploded.png]
Exploded RESET cartridge and hardware


## Assembly order

1. **Clean the printed parts and fit the inserts.** Remove support remnants
   and burrs from the guides, magnet pockets and screw passages. With the
   electronics and magnets absent, install the two short body inserts
   horizontally from outside toward the board. Install the contact insert
   downward into the top of the slider's round boss. Seat all inserts square
   and flush, let them cool, and check that the nylon screw threads smoothly
   through the insert and its tip clears the boss's through-hole. Keep heat and
   displaced plastic out of the sliding surfaces.

2. **Dry-fit the slider, then fit the board, clamps and USB plug.** With the rear keeper
   off, lower the slider vertically into the open U-guide. The arm remains
   pointed inward; it does not thread through a narrow rear window. Check
   smooth movement, then remove the slider for magnet installation. Install
   the PCB and its edge clamps before attaching the cartridges: the BOOT arm
   obstructs access to the left-front PCB clamp screw. Fit the USB plug before
   the cartridges as well: the retained exterior housings can obstruct a
   straight plug insertion path. Check your actual plug and cable throughout
   button travel. Leave the nylon contact
   screws out until the cartridges are installed and alignment is checked.

3. **Identify the repelling magnet faces.** Each disc's two flat faces are its
   poles. Find a pair of faces that repel and mark those facing surfaces.
   In the bench orientation, the fixed magnet's **upper face** and the moving
   magnet's **lower face** must have the same pole: N facing N or S facing S.
   Marking the same pole and putting both marked faces upward would make the
   facing poles attract.

4. **Load the magnets and tiny keeper.** Slide the fixed disc through the
   frame's open outside/rear channel into its pocket. Slide the moving disc
   into the slider's rear pocket, then insert the tiny rectangular
   moving-magnet keeper behind it. The discs sit with their flat faces
   horizontal. Hold the tiny keeper in place until the large rear keeper is
   fitted and bolted; the completed housing captures the tiny plug. The magnets
   are mechanically retained when assembled; adhesive is not part of this design.

5. **Lower the slider into the frame and close the rear.** With the large rear
   keeper still off, lower the loaded slider straight down into the U-guide,
   arm inward. Keep the tiny keeper seated. Fit the large rear keeper from
   outside: its tongue closes the fixed-magnet channel, and its window captures
   the slider's rear stop lug. If it will not sit flush, check the tongue,
   magnet and lug positions before tightening anything.

6. **Mount the cartridge.** Hold the assembled cartridge against the body's
   exterior pads. Insert both M3 × 18 screws from outside, through the rear
   keeper and frame, into the short body inserts. Snug them evenly and check
   that the slider still moves freely and returns when released. These screws
   secure both the cartridge and its rear keeper; the modeled joint assumes
   no washers. Repeat with the other button's named parts. Keep the contact
   screws absent if the arms do not align with the actual switches.

7. **Install the nylon contact adjuster after checking alignment.** Thread the
   nylon jam nut onto the nylon screw first. Feed the screw **from above the
   round boss**, through its insert, with the tip pointing down toward the
   switch. The screw head and jam nut stay on the lid side of the boss. After
   setting the contact height, hold the screw still and snug the jam nut
   against the boss to lock the setting. Use the nylon tip specified here.

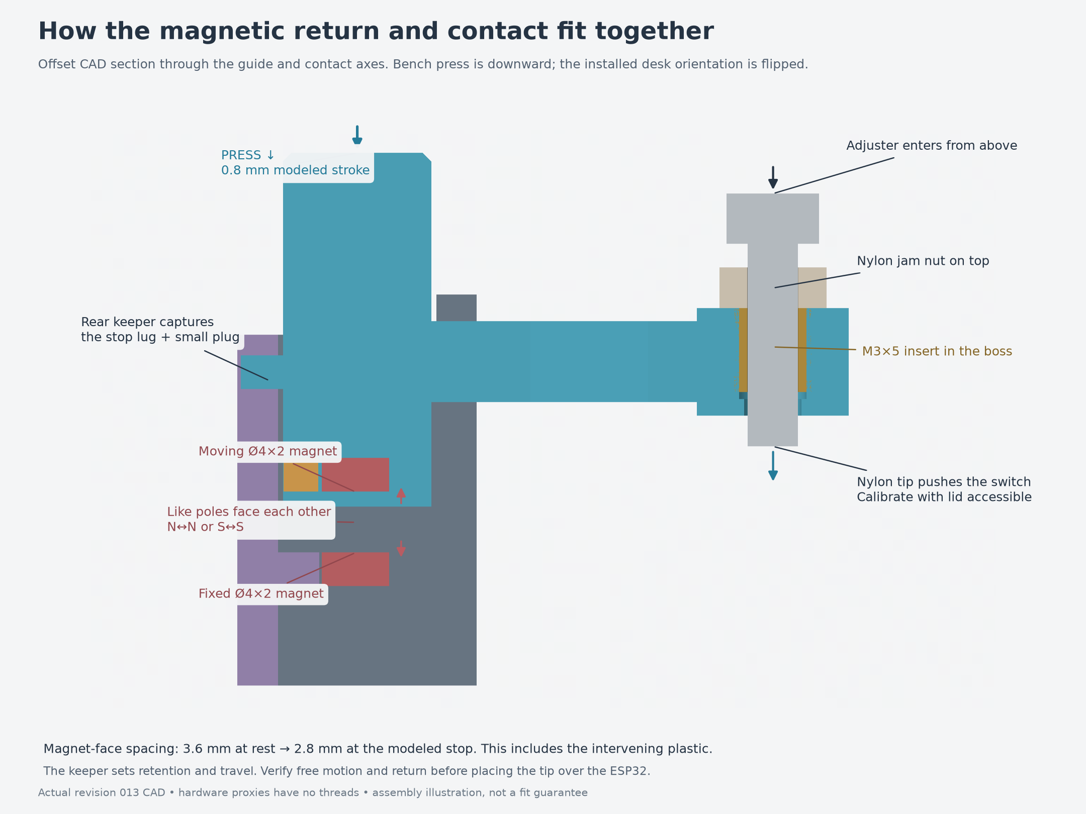
[picture p48: Models/ESP32Enclosure/assembly-guides/013-buttons/02-reset-cutaway.png]
Sectioned RESET cartridge showing magnet faces and contact adjustment


## Setting and testing the contacts

First confirm that each tip is centered over its actual switch and that the
board is held securely by the shelves and clamps. Center it and check both
tips together before using a contact screw to press a switch. Check available
board movement as described in the quick-test instructions.

- At rest, the switch must be fully released, with clearance under the tip.
- Press slowly. The switch should actuate reliably, then the **printed slider
  stops** must limit travel before the switch is overloaded. The switch itself
  must not serve as the mechanical stop.
- Release the pad. It must return freely and fully release the switch. Test
  each button separately, then recheck after locking its jam nut.
- Close the lid gently and check screw-head clearance. The current nominal
  model has only **0.4 mm** above the adjuster head; backing the screw out
  raises the head and can make it hit the lid. Check your actual head and nut
  sizes. Do not force the lid closed against an adjuster.
- Repeat with the enclosure inverted in its intended under-desk orientation,
  before fastening it to the desk. The PCB has 0.2 mm nominal vertical play;
  check it seated against the retaining clamps as it will be when mounted.

The model uses 0.8 mm slider travel, a 0.6 mm rest gap and 0.2 mm switch
depression. These are **CAD assumptions, not measured switch settings**.
Magnetic return force, friction and physical switch travel still need testing.
If release, actuation, printed-stop protection and lid clearance cannot all be
achieved, revise the geometry or adjustment range before continuing.

## Recognizing the pieces and servicing

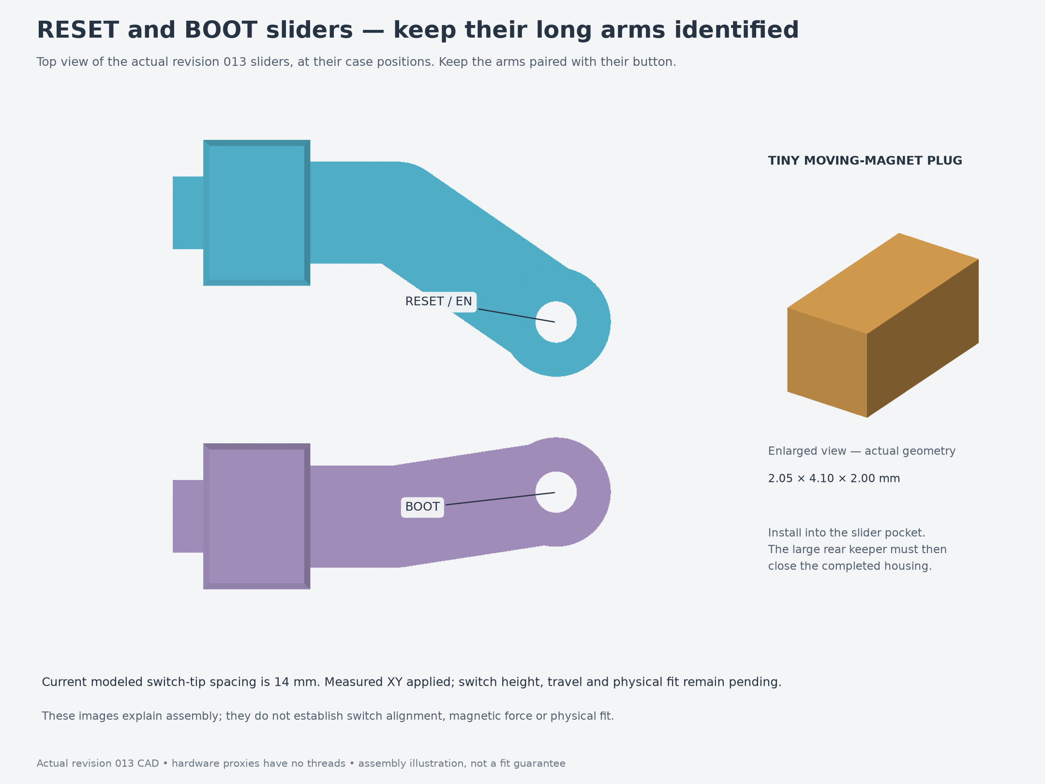
[picture p49: Models/ESP32Enclosure/assembly-guides/013-buttons/03-slider-comparison.png]
Revision 013 RESET and BOOT slider comparison


If a pad sticks, check support scars, guide fit and keeper seating. If it pulls
toward the fixed magnet instead of returning, check the facing poles. Neither
problem is corrected by tightening the mounting screws harder.

To service a cartridge, remove its two mounting screws while holding the rear
keeper and slider together; removing the keeper releases the captured parts.
Contain the two small magnets and tiny keeper. Remove the BOOT cartridge first
when access to the left-front PCB clamp screw is needed.

## Diagram source

The diagrams show the revision 013 CAD shapes, including the extended finger
pads and revised slider arms. Hardware is represented by simplified CAD
proxies. Exploded positions and section cuts are for illustration; these are
not additional printable parts.

The accompanying [render script](render-guide.py) regenerates the diagrams
from the preserved revision source. See its [source manifest](source-manifest.json)
for input hashes. From the package root:

```bash
uv run --locked python assembly-guides/013-buttons/render-guide.py \
  --source revisions/013-measured-buttons --output assembly-guides/013-buttons
```
