EasyAsABC123/Chromance/Models/ESP32Enclosure/revisions/011-fit-and-cable-cradle/printing-notes.md

# Printing and assembly notes

Model geometry in millimeters; no slicer profile or physical testing applied.

- Revision 011 reduces the full enclosure width by 3 mm total after the user reported the locking shelves 3 mm too far apart. Each retention side moves inward 1.5 mm. Body, lid and bracket must be replaced together; previous revisions are preserved.
- Measured PCB is 49 x 70 x 1 mm. Solder allowance is deliberately 6.6 mm to preserve the PCB top at local Z10 and the case rim at Z32; this allowance is a placement choice, not a measured solder height. The 52 mm populated ESP32 span is separate from the substrate.
- The existing button Y layout and 3 mm left-edge inset remain provisional. Confirmed centers at 30/16 mm from the bottom and 3.3 mm from the left need a dedicated actuator revision; this board-width correction does not claim button alignment.
- The 8.4 mm cylindrical cut forms an open concave groove for the measured 8 mm cable. Radial allowance is 0.2 mm, with 2 mm side walls and 2 mm material above the tie tunnel.
- The cradle extends along the cable for 8 mm. Its underside and tie-tunnel roof use 45 degree slopes. The tunnel is 3.2 mm wide for a provisional 2.5 x 1 mm strap. Thread with the lid open, seat the cable in the groove, and snug the tie over it with the head above the right shoulder.
- Cable diameter is measured; groove clearance, zip-tie dimensions, head size and physical fit remain unverified. Keep slack between the retention point and terminals. Standard ties may need cutting and replacing for removal.
- Print fit-tests/005-board-width and fit-tests/006-cable-cradle before a full replacement. Both derive their interfaces from this same full-model source. Record dimensions, material/settings and pass/fail observations; coupons do not establish full-part strength or warping.
- PCB edge clamps retain M3x5 heat-set inserts and M3x6 screws, with 4 mm engagement and 2 mm blind-tip margin. No screws pass through the PCB. The capture slot is PCB thickness plus 0.2 mm play; verify bare-edge overlap and solder clearance.
- Install PCB inserts before board/cartridges. The diameter 6 mm tool probe needs at least 21.8 mm narrow reach with 0.1 mm nominal wall clearance. Actual iron access needs checking; remove the BOOT cartridge for left-front screw service.
- Lid joints retain M3x5 heat sets and M3x8 screws in short corner pads with paired 45 degree ribs. Pilot diameter/depth are 4/6 mm; screw engagement is 5 mm with 0.4 mm blind-tip margin. Install flush from the open rim. Do not reuse M3x10 lid screws.
- Four bracket M3x5 inserts use M3x10 screws; two contact M3x5 inserts use nylon M3x12 adjusters and exposed jam nuts. Four cartridge inserts remain M3x4 with M3x18 screws. No printed captive hex-nut pockets remain. M3x5 specifies thread and length, not insert outside diameter: OD4.6/pilot4.0 remain provisional.
- The lid and extended finger pads face downward when mounted; press upward through 0.8 mm nominal travel. Desk contact remains at Z43.2, but the desk/bracket screw X positions move inward 1.5 mm per side with the narrower case.
- Print the body floor-down, lid exterior-down and bracket desk-contact-face down. Start with supports off for the cradle/corner ribs and inspect their ramps and short bridges in the slicer. Sliders require local removable support beneath stepped arms; protect guide and magnet seats. No supports are modeled.
- Use the intended final material/nozzle/layer settings for coupons. Unfilled PETG remains the initial candidate; material choice and settings are not validated here. Geometry 3MFs are not slicer projects or G-code. No print-time, strain-relief-force, mounting-strength or creep rating is assigned.
- Support electronics when opening the downward-facing lid. Return force, contact height/travel, connector envelopes, thermal behavior and RF performance require physical checks; use nylon contact tips. The low-voltage controller is enclosed separately from the external PSU.
- Retain all five CAD inputs and the build/render helpers together. Reference cable/tie/hardware solids are excluded from printable exports; hardware STEP contains simplified proxies and is not a complete fastener assembly.
