EasyAsABC123/Chromance/Models/ESP32Enclosure/revisions/008-corner-bosses/printing-notes.md

# Printing and assembly notes

Model geometry in millimeters; no slicer profile or physical testing applied.

- Revision008 replaces the four tall lid columns with short solid corner pads and paired sloping supports. Reprint the body and lid; only the four local skirt segments change on the lid. Thirteen other printed parts and every hardware axis remain unchanged from007. All older revisions and board-fit tests remain preserved.
- Each upper corner pad projects 8.4 mm inward from both adjacent walls and overlaps them by 0.4 mm. The pad runs from localZ24 to32, leaving 2 mm of solid material below the entire blind pilot.
- Two joined 45-degree underside wedges begin at localZ15.6 on the inner wall faces. Their union grows each print layer from the nearer wall, including diagonal regions. No modeled supports are added for these bosses; inspect the actual slicer preview.
- The filled corner gaps formerly housed small lid-skirt segments. These are removed locally with 0.3 mm clearance; the exterior lid face, screw holes and remaining skirt are retained.
- CAD body volume changes from 49.534 to 46.405 cm3, a reduction of 3.129 cm3 (6.32%). Raw and net corner-feature volumes are recorded separately. These are geometry volumes, not print-time or strength predictions.
- The enclosure and its hardware rotate 180 degrees about X, then translate by Z=38 mm. The USB/button side stays -X; the cable end changes from +Y to -Y. World +Z points toward the desk.
- The floor faces the desk with 2 mm clearance below the bracket plate. The lid and extended paddle faces point downward: reach from below and press upward through 0.8 mm nominal travel.
- Each existing finger pad is extended 7 mm in its original local +Z direction, with 0.6 mm overlap and a new 0.5 mm top chamfer. Guide, magnets, contact insert, nylon tip and positive stops are unchanged; motion remains rigid 1:1.
- All button parameters and their original measurement fields remain in the source frame. Use mount_transform for world placement and slider_pad_extensions for the added pads; buttons[name].pad_world gives the new exposed faces and press direction.
- Desk contact remains at Z=43.2 mm and all four desk screw positions are unchanged. Straight bracket legs leave 0.6 mm belt clearance along the full insertion path and 0.3 mm clearance to the existing ear gussets.
- The existing bracket uses four M3x5 heat-set inserts. Its M3x10 screws pass upward through the flipped5 mm ears for 5 mm nominal insert engagement and 0.4 mm blind-tip clearance. Neither lid nor PCB clamps require captive hex nuts.
- PCB clamps use four M3x5 inserts and M3x6 socket screws. Their holes move 0.4 mm outward while the ledges, locating shoulders and PCB capture slots stay unchanged. The new diameter8.8 mm bosses retain 2.1 mm nominal radial polymer around provisional OD4.6 mm inserts.
- PCB pilots are diameter4 x6 mm deep, from localZ10.2 down to4.2. M3x6 screws through the2 mm clamps give 4 mm engagement and 2 mm blind-tip margin. Do not reuse the old M3x8 PCB screws, which bottom in the new pilots. No washers are assumed.
- Install PCB inserts before the board/cartridges. The modeled access uses a diameter6 mm narrow tool reaching at least21.8 mm from each boss top to the shell rim, with only0.1 mm nominal side-wall clearance. A bulky iron cannot follow that straight path; verify the actual tool. Remove the BOOT cartridge for later left-front clamp screw service.
- All printed captive-nut pockets and their lower side-entry slots are removed. The narrow PCB-edge capture slots, magnetic-guide openings and magnet keeper pockets are intentional and remain. Two exposed nylon contact jam nuts remain separate hardware, with no printed nut traps.
- Lid hardware remains four M3x5 heat-set inserts, provisional OD4.6 mm, and four M3x8 socket screws. The pilot is diameter4 x6 mm deep; the new 8.8 mm square corner pad retains at least 2.1 mm of material to the insert envelope.
- Each lid screw passes through 2.4 mm of lid and projects 5.6 mm, engaging the full 5 mm insert with 0.4 mm blind-tip clearance. Do not reuse revision005 M3x10 lid screws: they bottom in these blind pilots. No washers are assumed.
- Install the four lid inserts flush from the open body rim before closing the lid. Actual insert outside diameter and the pilot fit remain provisional; verify the purchased insert and the intended filament with a fit coupon.
- Bracket insert OD 4.6 mm and pilot 4 mm remain provisional. Blind pilot depth is 5.4 mm; the printed legs retain 1.9 mm inboard and 2 mm Y material to the insert envelope. Verify the actual insert drawing and a printed fit coupon.
- Install the bracket inserts from the lower leg faces on the bench. Fix the bracket to the desk, raise the enclosure vertically between its legs, and fit the four M3x10 screws from below. Select desk screw penetration after measuring desk material and thickness.
- Each bracket insert intentionally displaces its own pilot. The exact insert/desk_bracket host pairs are declared separately from unexpected interference; hardware proxies are excluded from printed exports.
- The original ears and their ribs carry enclosure weight through the four M3 screws into the bracket posts and crossbars. Top gussets distribute post load. No strength or creep load rating is assigned.
- With the PCB inverted, its four removable edge clamps support board weight. Confirm the provisional 0.8 mm bare-edge overlap and retention; secure heavy cables independently.
- Print the new bracket with its desk-contact face on the bed. Print the extended sliders with their new finger-pad faces on the bed, matching the original slider rotation; the longer extensions raise the arms and guides farther from the bed, so local removable supports are needed. Protect guide and magnet fits from support scars.
- All remaining parts retain revision004 print orientation. The M3x5 contact inserts, nylon M3x12 adjusters, short M3x4 body inserts, magnets and travel stops remain unchanged at default settings. Contact adjustment requires lid access; the BOOT-side PCB clamp requires cartridge removal.
- Support the electronics when opening the downward-facing lid. Remove the enclosure for initial wiring, slider service and calibration. Do not substitute metal contact tips over the PCB.
- Current board outline 52x70 mm, PCB 1.6 mm, solder clearance 6 mm and component/wire clearance 22 mm remain provisional. Actual connectors, switch positions, magnetic force, printed fit, strength, temperature and RF behavior require physical validation.
- The separate fit-tests/002-board-fit-heatsets experiment uses the measured49x70x1 mm PCB and heat-set edge clamps. Those new measurements and fourteen-millimeter button spacing are not integrated into this compatibility revision; the archived revision005 PCB/button layout is retained here.
- Retain base_model.py, button_module.py and mounting.py beside this wrapper. The base source defines the new lid corner supports and skirt relief; button_module.py and mounting.py remain byte-identical to007. The unexported full-height comparison body is only for volume and preservation checks.
