EasyAsABC123/Chromance/Models/ESP32Enclosure/fit-tests/006-cable-cradle/printing-notes.md

# Printing and assembly notes

Model geometry in millimeters; no slicer profile or physical testing applied.

- Quick iterative fit print extracted from the full revision011 source and parameters at true scale; previous fit tests remain preserved.
- Print the body floor-down and the lid exterior-down, matching the full enclosure. Use the intended final material, nozzle, layer height and compensation; these are not a slicer project or G-code.
- Start with supports off for the new cradle, inspect its ramp and tie passage in your slicer, and avoid support scars in cable/tie contact surfaces.
- Thread the actual zip tie through the passage, lay the cable into the concave cylindrical groove, then snug the tie over the cable with its head above the right shoulder. Check head position and trimming access before tightening.
- Seat the matching lid section by hand; it must sit flush without compressing the cable or zip-tie head. This coupon has no lid screws and does not test the full lid joint.
- Record cable/bundle dimensions, tie dimensions, material and print settings, whether threading/closure work, any sharp contact or slipping during gentle handling, and any measured clearance error.
- Use a standard one-way tie; cut it to release the cable, protecting the jacket. Physical results are pending. Do not infer a rated strain-relief force, full enclosure fit, whole-shell stiffness or long-term material behavior from this coupon.
