EasyAsABC123/Chromance/Models/ESP32Enclosure/fit-tests/009-usb-clearance/print-layout.png

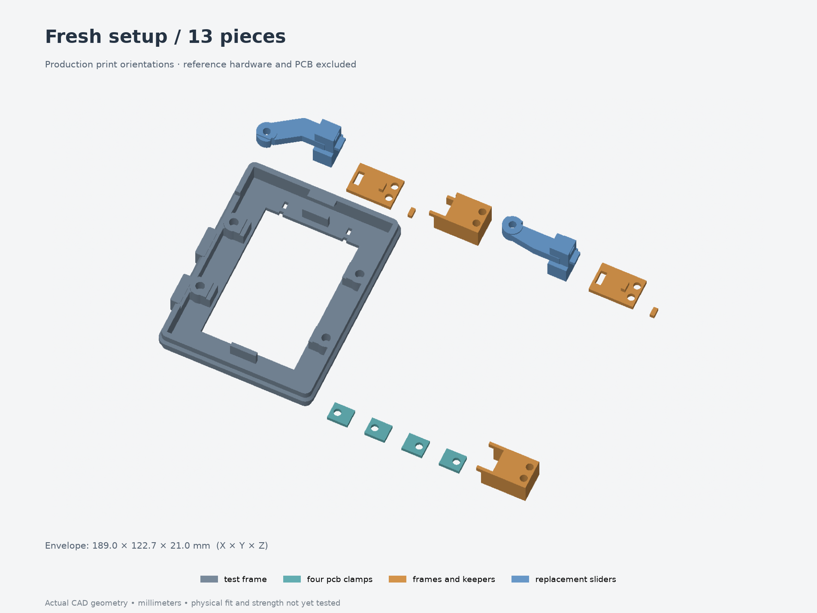
Models/ESP32Enclosure/fit-tests/009-usb-clearance/print-layout.png
