EasyAsABC123/Chromance/Models/ESP32Enclosure/revisions/008-corner-bosses/print-layout.png

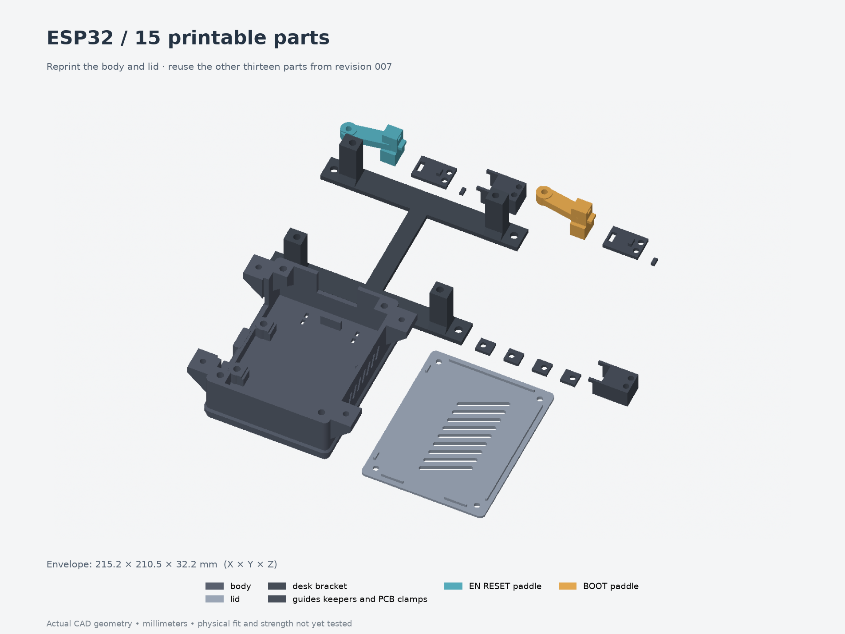
Models/ESP32Enclosure/revisions/008-corner-bosses/print-layout.png
