EasyAsABC123/Chromance/Models/ESP32Enclosure/revisions/013-measured-buttons/exploded.png

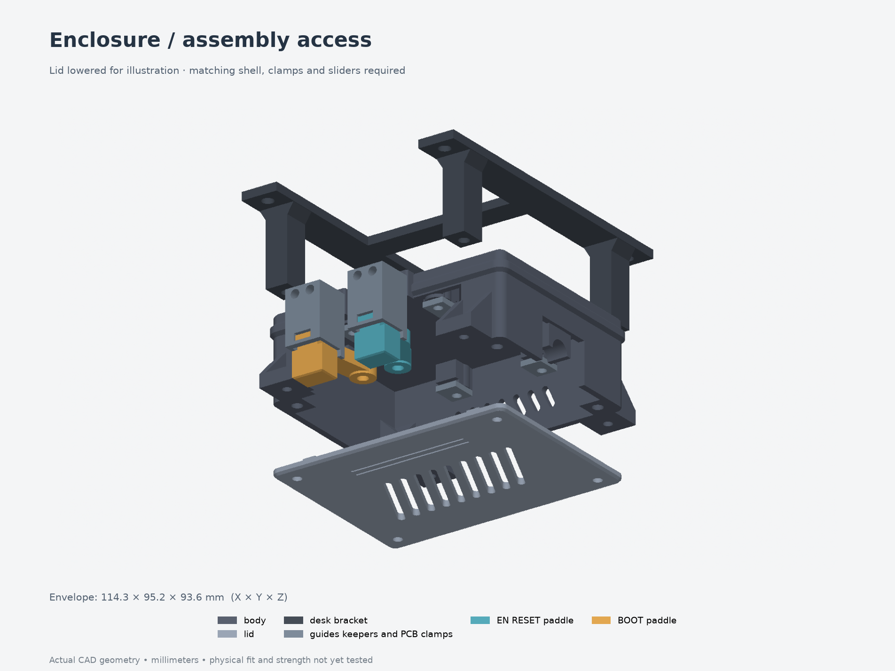
Models/ESP32Enclosure/revisions/013-measured-buttons/exploded.png
