EasyAsABC123/Chromance/Models/ESP32Enclosure/revisions/013-measured-buttons/under-desk.png

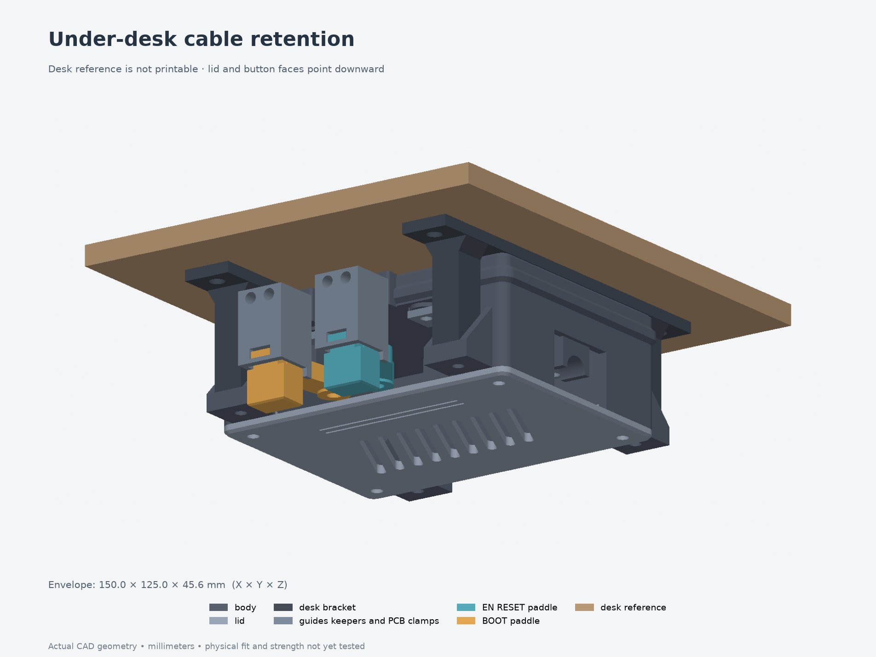
Models/ESP32Enclosure/revisions/013-measured-buttons/under-desk.png
