EasyAsABC123/Chromance/Models/ESP32Enclosure/revisions/002-console/comparison.png

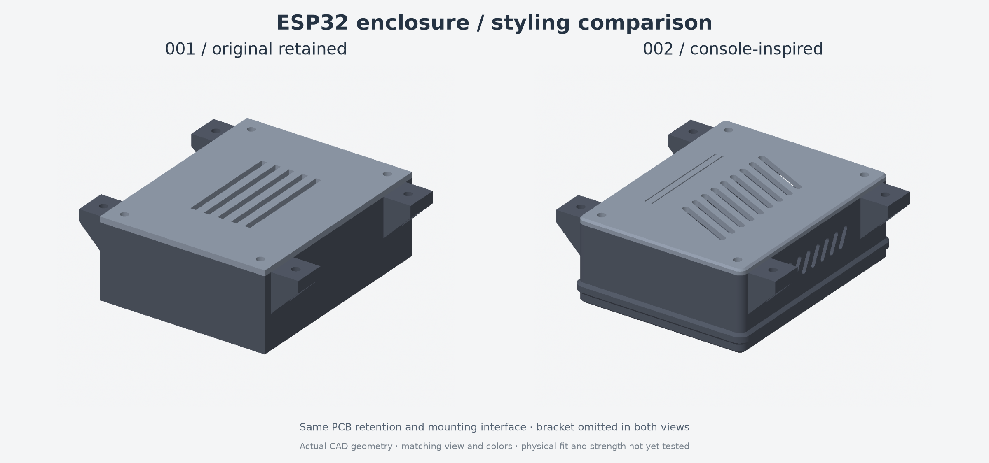
Models/ESP32Enclosure/revisions/002-console/comparison.png
