EasyAsABC123/Chromance/Models/ESP32Enclosure/revisions/002-console/console.png

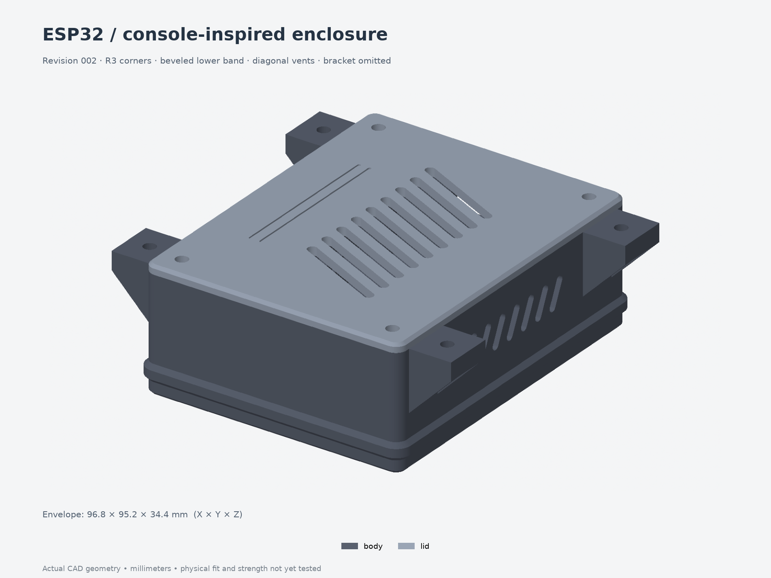
Models/ESP32Enclosure/revisions/002-console/console.png
