EasyAsABC123/Chromance/Models/ESP32Enclosure/revisions/004-heatsets/button-mechanism.png

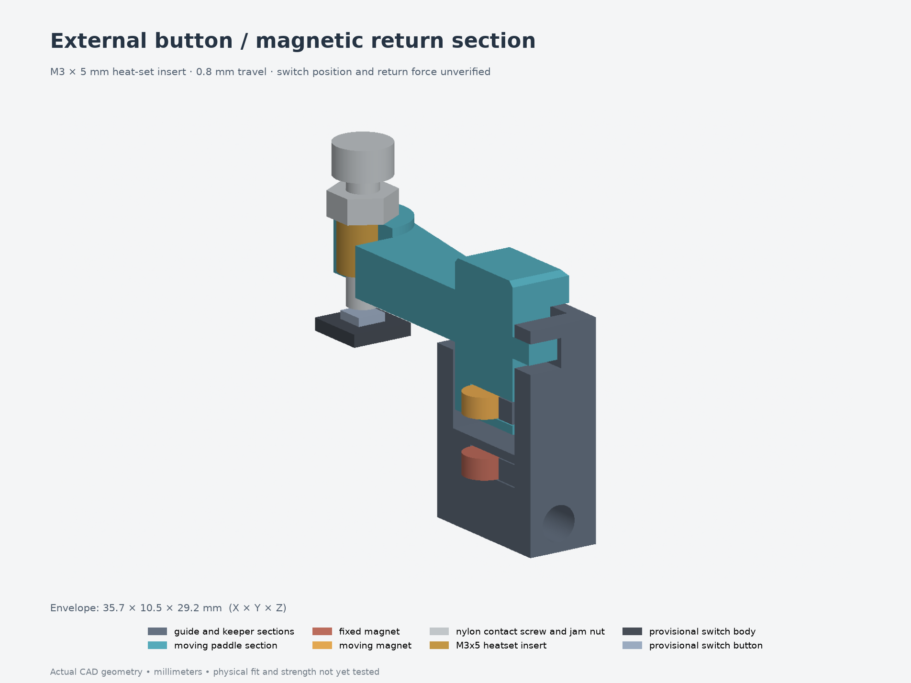
Models/ESP32Enclosure/revisions/004-heatsets/button-mechanism.png
