EasyAsABC123/Chromance/Models/ESP32Enclosure/revisions/008-corner-bosses/button-mechanism.png

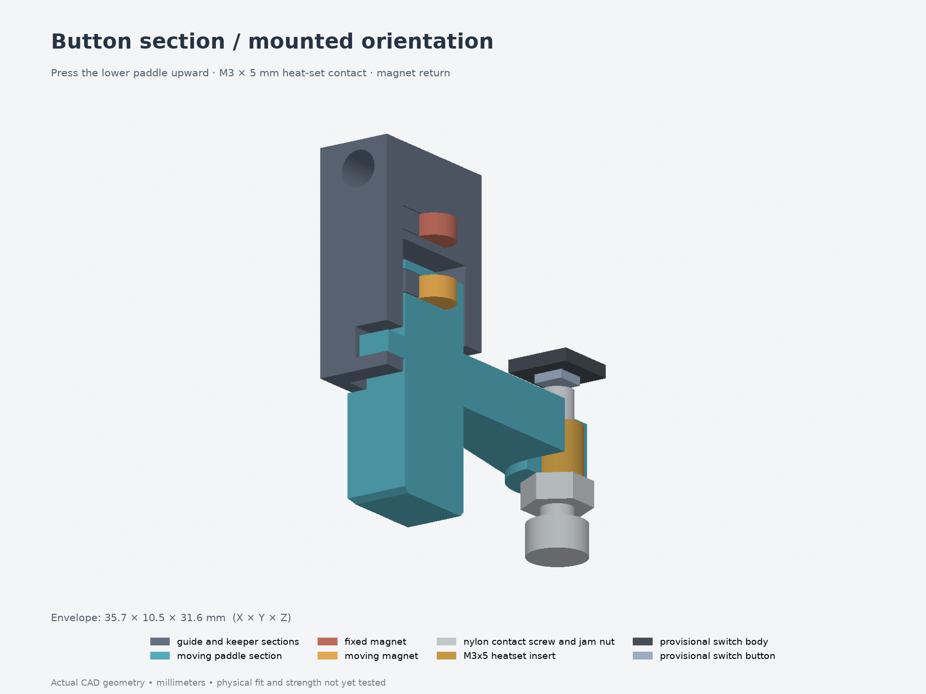
Models/ESP32Enclosure/revisions/008-corner-bosses/button-mechanism.png
