EasyAsABC123/Chromance/Models/ESP32Enclosure/revisions/008-corner-bosses/console-buttons.png

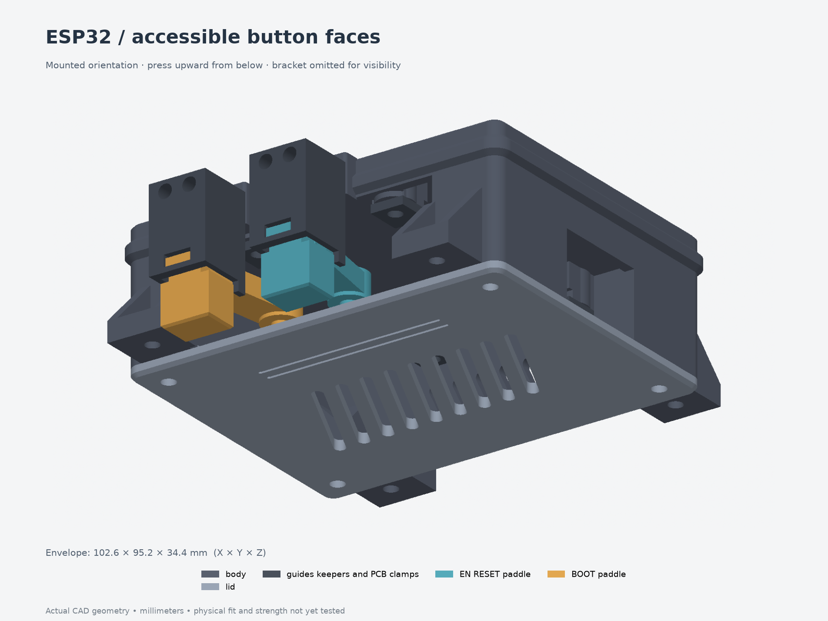
Models/ESP32Enclosure/revisions/008-corner-bosses/console-buttons.png
