EasyAsABC123/Chromance/Models/ESP32Enclosure/revisions/008-corner-bosses/preview.png

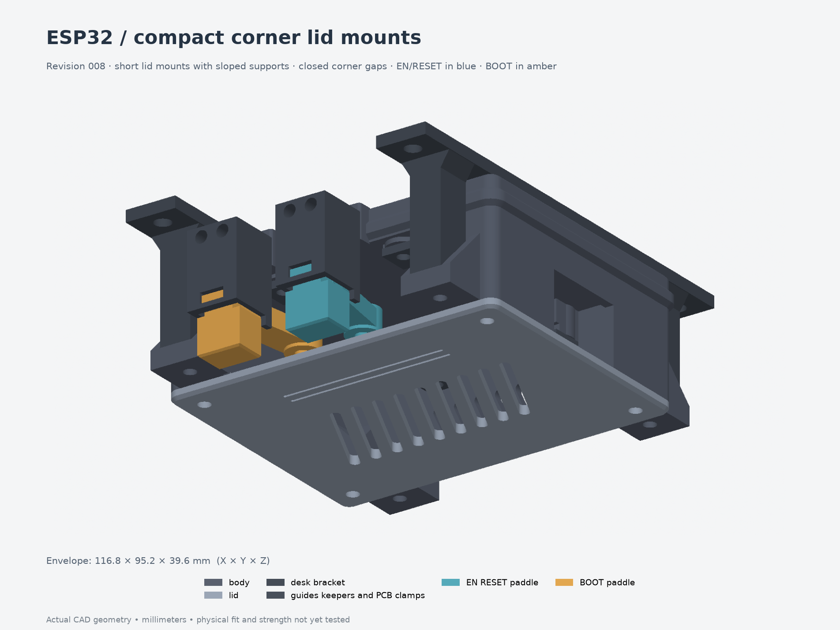
Models/ESP32Enclosure/revisions/008-corner-bosses/preview.png
