EasyAsABC123/Chromance/Models/ESP32Enclosure/revisions/008-corner-bosses/under-desk.png

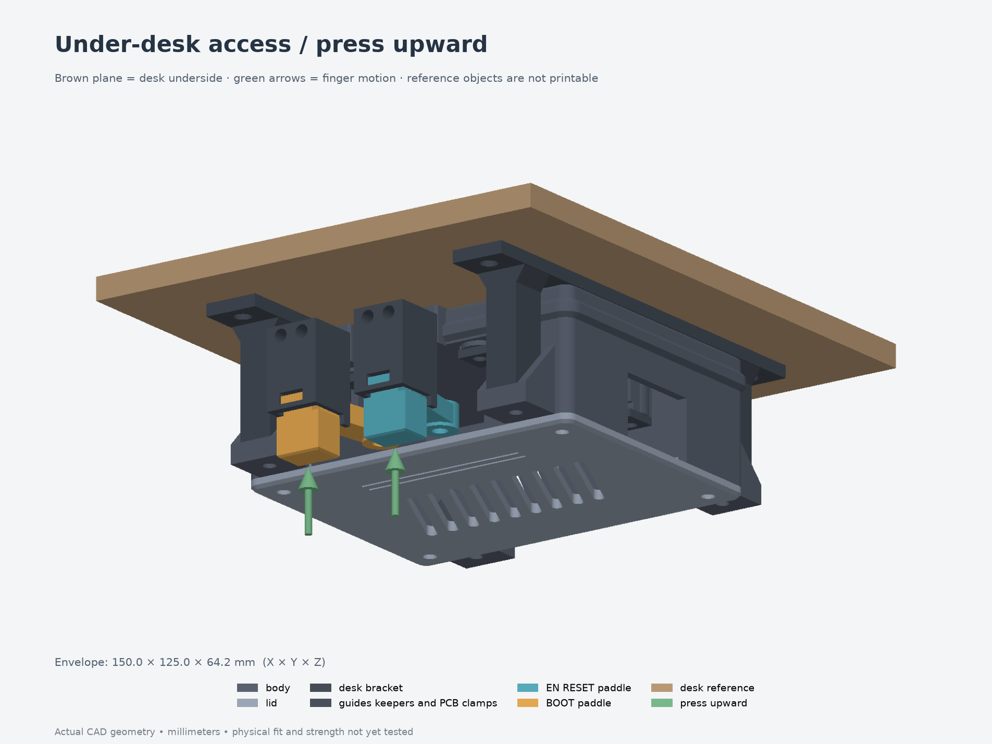
Models/ESP32Enclosure/revisions/008-corner-bosses/under-desk.png
