EasyAsABC123/Chromance/Models/ESP32Enclosure/revisions/010-8mm-cable/cable-closure.png

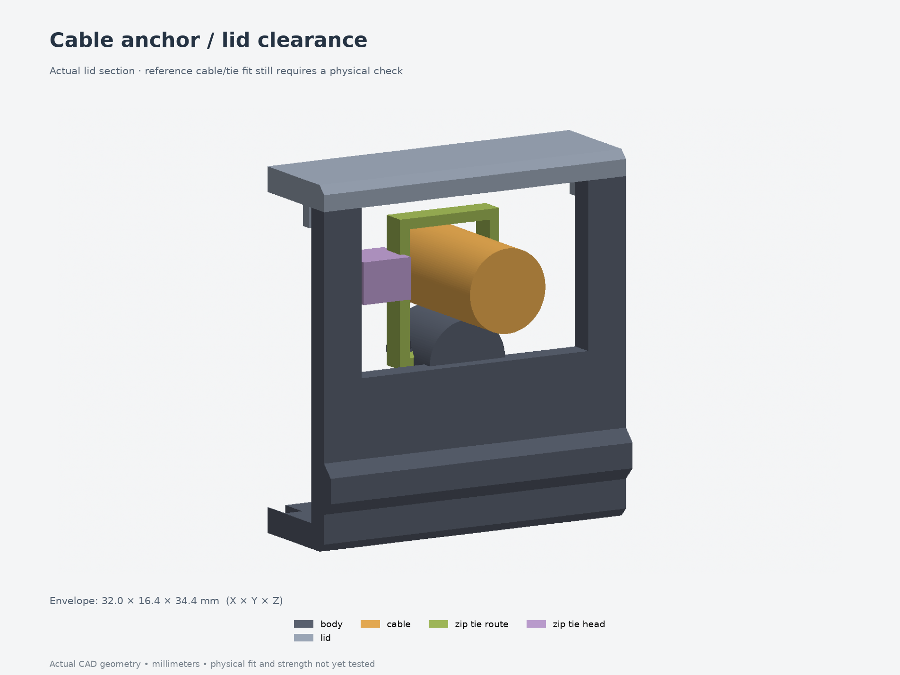
Models/ESP32Enclosure/revisions/010-8mm-cable/cable-closure.png
