EasyAsABC123/Chromance/Models/ESP32Enclosure/revisions/011-fit-and-cable-cradle/preview.png

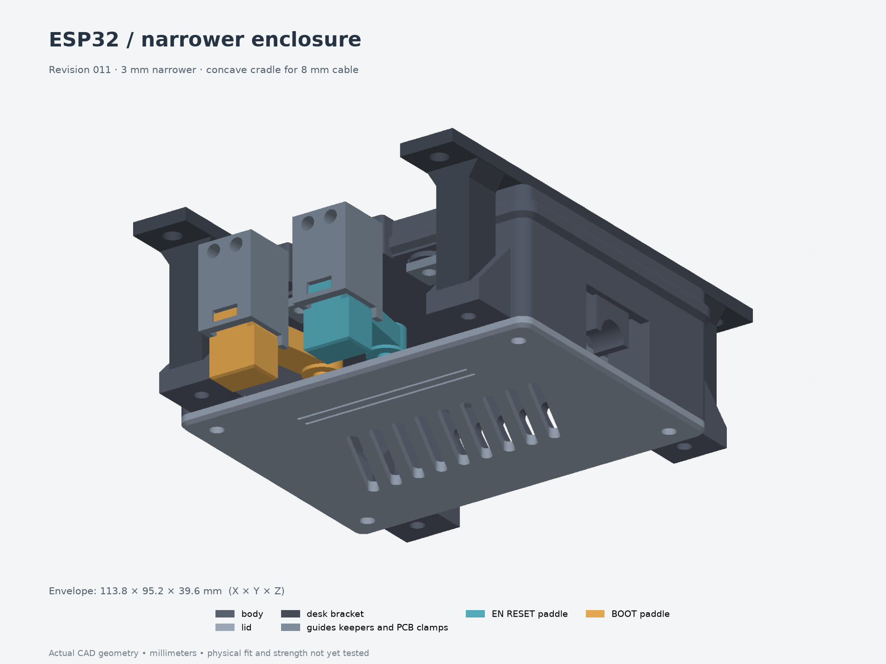
Models/ESP32Enclosure/revisions/011-fit-and-cable-cradle/preview.png
