EasyAsABC123/Chromance/(list of files, drawings)

Other design files:
Models/ESP32Enclosure/revisions/007-pcb-heatsets/pcb-validation.json
