EasyAsABC123/Chromance/chromance-firmware/src/animations/Animation.h

#ifndef ANIMATION_H
#define ANIMATION_H

#include <Arduino.h>
#include "../ripple.h"
#include "../Constants.h"

#include <ArduinoJson.h>

class AnimationController;

class Animation
{
public:
  Animation(AnimationController &controller, bool enabled = true) : controller(controller), enabled(enabled) {}
  virtual ~Animation() {}

  virtual void run() = 0;
  virtual void update() {}
  virtual void stop() {}
  virtual bool canBePreempted() { return true; }
  virtual bool isFinished() { return true; }
  bool isEnabled() const { return enabled; }
  virtual const char *getName() const = 0;
  virtual bool hasConfig() const { return false; }
  virtual void getConfig(JsonObject &doc) {
      doc["enabled"] = enabled;
  }
  virtual void setConfig(const JsonObject &doc) {
      if (doc["enabled"].is<bool>()) {
          enabled = doc["enabled"];
      }
  }

protected:
  AnimationController &controller;
  bool enabled;
};

#endif
