EasyAsABC123/Chromance/chromance-firmware/src/animations/StarburstAnimation.h

#ifndef STARBURST_ANIMATION_H
#define STARBURST_ANIMATION_H

#include "Animation.h"

class StarburstAnimation : public Animation
{
public:
  StarburstAnimation(AnimationController &controller) : Animation(controller, Constants::starburstPulsesEnabled) {}
  void run() override;
  const char* getName() const override { return "Starburst"; }
};

#endif
