EasyAsABC123/Chromance/chromance-firmware/src/Utils.h

#ifndef UTILS_H
#define UTILS_H

inline float fmap(float x, float in_min, float in_max, float out_min, float out_max)
{
  return (x - in_min) * (out_max - out_min) / (in_max - in_min) + out_min;
}

#endif // UTILS_H
