EasyAsABC123/Chromance/(commit log)

2026-01-12 update to have max current and to remove duplicate functions in emulator
2026-01-13 update rainbow to have gradient, minor memory leak
    [Configuration.h]
2026-01-29 Documentation + Web interface updatings for settings
    [Configuration.h]
2026-01-30 More animations Meteor Shower, Shooting Star, Searchlight, Bio Pulse, Glitch
    [AnimationController.cpp, BioPulseAnimation.cpp, BioPulseAnimation.h, Constants.h, GlitchAnimation.cpp, GlitchAnimation.h, MeteorShowerAnimation.cpp, MeteorShowerAnimation.h]
2026-01-30 More animations bouncing ball, fireflies, fireworks, inferno, water, issues fixed on rainbow radiate and pinwheel
    [AnimationController.cpp, BouncingBallsAnimation.cpp, BouncingBallsAnimation.h, Configuration.cpp, Constants.h, FirefliesAnimation.cpp, FirefliesAnimation.h, FireworksAnimation.cpp]
2026-02-02 Feat: Randomize FireworksAnimation start node
    Modified FireworksAnimation to start rockets from a random bottom node (0, 1, or 2)
    instead of the fixed top node (24).
    Adjusted direction finding logic to correctly launch rockets upwards from bottom nodes.
    Updated pathfinding and ripple start calls to use the new random start node.
    [FireworksAnimation.cpp]
2026-02-03 Revert "Feat: Randomize FireworksAnimation start node"
    This reverts commit fcf250c054155dce67123e7717bc2cd5a781b793.
    [FireworksAnimation.cpp]
2026-02-03 Fix: Correct FireworksAnimation logic
    - Set targetNode to a random top node to ensure rocket travels upwards.
    - Simplified rocketDuration to a random value to encourage mid-air explosions,
    rather than exploding upon reaching the target.
    [FireworksAnimation.cpp]
2026-02-05 Added more animations, minor fixes to make animations more fun, save configuration over restarts, and start back up without deep sleep when button on esp32 is pressed
    [Configuration.h]
2026-02-06 more animations and fixes
    [AnimationController.cpp, AnimationController.h, AnimationRegistry.h, BioPulseAnimation.cpp, BouncingBallsAnimation.cpp, CenterAnimation.cpp, ChaseAnimation.cpp, ChromanceWebServer.cpp]
2026-09-09 Add parametric ESP32 enclosure with M3 heat-set button actuators
    [assembly.step, body.3mf, body.step, boot_frame.3mf, boot_frame.step, boot_moving_magnet_keeper.3mf, boot_moving_magnet_keeper.step, boot_rear_keeper.3mf]
2026-09-09 Add Fusion script to export and verify native enclosure archives
2026-09-10 Reorient enclosure for downward-facing push-up buttons
    [assembly.step, body.3mf, body.step, boot_frame.3mf, boot_frame.step, boot_moving_magnet_keeper.3mf, boot_moving_magnet_keeper.step, boot_rear_keeper.3mf]
2026-09-10 Add board-fit print and publish reusable CAD skills
    [assembly.step, board_fit_tray.3mf, board_fit_tray.step, inspection.FCStd, pcb_clamp_left_front.3mf, pcb_clamp_left_front.step, pcb_clamp_left_rear.3mf, pcb_clamp_left_rear.step]
2026-09-10 Correct PCB fit dimensions and add heat-set clamp fasteners
    [assembly.step, board_fit_tray.3mf, board_fit_tray.step, hardware-reference.step, inspection.FCStd, pcb_clamp_left_front.3mf, pcb_clamp_left_front.step, pcb_clamp_left_rear.3mf]
2026-09-11 Replace enclosure lid nuts with M3 heat-set inserts
    [assembly.step, body.3mf, body.step, boot_frame.3mf, boot_frame.step, boot_moving_magnet_keeper.3mf, boot_moving_magnet_keeper.step, boot_rear_keeper.3mf]
2026-09-11 Replace remaining PCB clamp nut traps with heat-set inserts
    [assembly.step, body.3mf, body.step, boot_frame.3mf, boot_frame.step, boot_moving_magnet_keeper.3mf, boot_moving_magnet_keeper.step, boot_rear_keeper.3mf]
2026-09-11 Replace full-height lid posts with supported corner bosses
    [assembly.step, body.3mf, body.step, boot_frame.3mf, boot_frame.step, boot_moving_magnet_keeper.3mf, boot_moving_magnet_keeper.step, boot_rear_keeper.3mf]
2026-09-11 Require quick iterative fit-test prints in 3D modeling skills
2026-09-11 Add rounded cable retention and an iterative zip-tie fit print
    [assembly.step, body.3mf, body.step, boot_frame.3mf, boot_frame.step, boot_moving_magnet_keeper.3mf, boot_moving_magnet_keeper.step, boot_rear_keeper.3mf]
2026-09-11 Record measured 8 mm cable and verify existing retention fit
    [assembly.step, body.3mf, body.step, boot_frame.3mf, boot_frame.step, boot_moving_magnet_keeper.3mf, boot_moving_magnet_keeper.step, boot_rear_keeper.3mf]
2026-09-11 Narrow enclosure 3 mm and add concave cable cradle with fit tests
    [assembly.step, board_fit_frame.3mf, board_fit_frame.step, body.3mf, body.step, boot_frame.3mf, boot_frame.step, boot_moving_magnet_keeper.3mf]
2026-09-11 Add 0.5 mm enclosure fit allowance and deeper PCB shelves
    [assembly.step, board_fit_frame.3mf, board_fit_frame.step, body.3mf, body.step, boot_frame.3mf, boot_frame.step, boot_moving_magnet_keeper.3mf]
2026-09-13 Remember concave cable cradles and zip-tie retention in CAD skills
2026-09-13 Align ESP32 button sliders to measured board datums
    Preserve revision 012 and add revision 013 with independent housing positions and two dogleg sliders targeting the confirmed 30/16 mm bottom offsets and 3.3 mm left inset. Include a two-slider trial, full open fit jig, measured-geometry checks and an illustrated button assembly guide. Record provisional USB plug conflicts and pending physical calibration.
    [assembly.step, body.3mf, body.step, boot_frame.3mf, boot_frame.step, boot_moving_magnet_keeper.3mf, boot_moving_magnet_keeper.step, boot_rear_keeper.3mf]
2026-09-13 Clear measured USB plug around ESP32 button sliders
    [assembly.step, body.3mf, body.step, boot_frame.3mf, boot_frame.step, boot_moving_magnet_keeper.3mf, boot_moving_magnet_keeper.step, boot_rear_keeper.3mf]
